Meltingth/WhizdomLift/docs/reference/HUD_VISUAL_REFERENCE.png

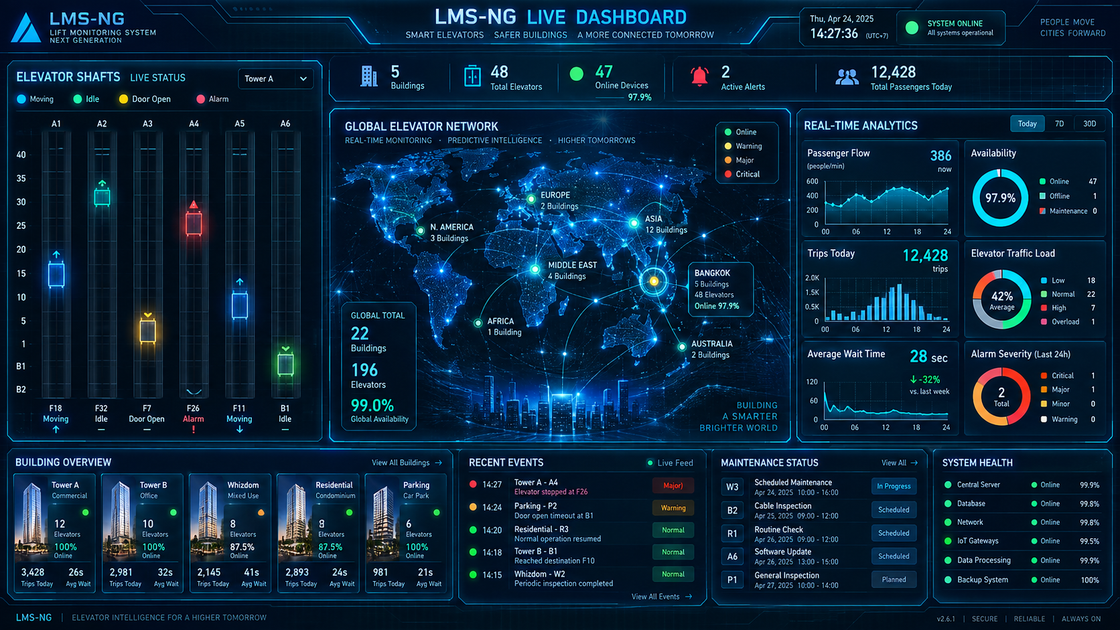
docs/reference/HUD_VISUAL_REFERENCE.png
