Meltingth/WhizdomLift/README.md

# WhizdomLift

ระบบอ่านสัญญาณตำแหน่งและสถานะลิฟต์ด้วย Arduino Mega 2560 — อ่านหน้าสัมผัสรีเลย์จากตู้ควบคุมลิฟต์ (รหัสตำแหน่ง 6 บิต VS2–VS7 + สถานะ RUNNING / SAFETY / UP / DN / FIRE) ผ่านแผงขั้วต่อ DNMEGA1 และโมดูลรีเลย์ 24V แบบ **read-only ทั้งระบบ** ไม่มีการขับสัญญาณกลับเข้าตู้ลิฟต์

🧭 **เริ่มอ่านที่นี่:** [CLAUDE.md](CLAUDE.md) — บริบทโปรเจกต์ฉบับเต็ม: แผนที่ขาที่ยืนยันแล้ว, สูตรถอดรหัส, กฎความปลอดภัย (**ห้ามตั้งขาเป็น OUTPUT**), บทเรียนจากบั๊กที่เคยให้คำตอบผิด และงานที่ยังเหลือ

🔧 **อัปเกรด firmware:** [FIRMWARE_UPGRADE.md](FIRMWARE_UPGRADE.md) — ทำที่เครื่องหน้าตู้ผ่าน USB เท่านั้น

🌐 **เครื่อง Gateway (รับ 5 ลิฟต์พร้อมกัน):** [GATEWAY.md](GATEWAY.md)

🔧 **แยกบอร์ดรีเลย์เสีย vs สาย input ขาด:** [LIFT1_VS2_RELAY_TEST.md](LIFT1_VS2_RELAY_TEST.md) — ขั้นตอนหน้าตู้สำหรับ Lift 1 VS2

🛗 **สถานะลิฟต์ทั้ง 5 ตัว + ขั้นตอนทดสอบ:** [LIFT_STATUS.md](LIFT_STATUS.md) — ลิฟต์ไหนตรวจแล้ว เจออะไร ต้องซ่อมอะไร

📋 **ผลการทดสอบล่าสุด:** [TEST_REPORT_2026-08-08.md](TEST_REPORT_2026-08-08.md) — ยืนยันความแม่นยำด้วย blind test 14/14 เหตุการณ์ พร้อมตารางสอบเทียบรหัส↔ชั้น และ checklist งานที่เหลือร่วมกับทีมดูแลลิฟต์

## โครงสร้าง

| ไฟล์ | หน้าที่ |
|---|---|
| `CLAUDE.md` | บริบทโปรเจกต์ + ข้อเท็จจริงที่ยืนยันแล้ว + บทเรียนจากบั๊ก — โหลดเข้า context อัตโนมัติทุก session |
| `TEST_REPORT_2026-08-08.md` | รายงานผลการทดสอบวันที่ 8 ส.ค. 2026 |
| `IODebug/IODebug.ino` | Sketch บนบอร์ด: อ่าน D2–D53 + A0–A15, watch mode ส่ง `ST <ms> <mask>` ทุกการเปลี่ยนแปลง |
| `LIFT_STATUS.md` | ตารางสถานะลิฟต์ทั้ง 5 + ขั้นตอนทดสอบทีละตัว |
| `GATEWAY.md` | คู่มือเครื่อง Gateway: รับ 5 ลิฟต์ผ่าน RS485 พร้อมกัน |
| `FIRMWARE_UPGRADE.md` | ขั้นตอนอัปเกรด firmware และสิ่งที่ Gateway จะเห็นระหว่างนั้น |
| `log_lift.py` | ตัวบันทึกถาวรต่อลิฟต์: `python log_lift.py COM3 3` — reconnect อัตโนมัติ, heartbeat 60 วิ, กันข้อมูลลิฟต์ปนกัน |
| `lift_health.py` | ตรวจสุขภาพลิฟต์เทียบลิฟต์ A: `python lift_health.py 2` — ชี้เส้นที่ไม่ส่งสัญญาณ |
| `rs485_check.py` | ตรวจลิงก์ RS485 แบบไม่ส่งอะไรออกสาย: `python rs485_check.py COM3 1` — บอกว่าบัสมีคนขับหรือไม่ |
| `lift_decode.py` | Config กลาง: แผนที่ขา→บิตของแต่ละลิฟต์ + ตารางแปลงรหัส→ป้ายชั้น |
| `analyze_lift.py` | ถอดแผนที่บิตอัตโนมัติจากพฤติกรรมสัญญาณ + ไทม์ไลน์ชั้น |
| `trips.py` | แยกเที่ยววิ่ง จุดจอด จุดแวะรับ + จำแนกสัญญาณสถานะ |
| `compare_lifts.py` | เทียบ wiring และรหัสระหว่างลิฟต์หลายตัว |
| `audit.py` / `reveal.py` / `probe_pin.py` | ตรวจข้อมูลดิบ, ตรวจคำตอบ blind test, ทดสอบขาแบบสด |
| `monitor.py` / `scan_pins.py` / `selftest.py` | เครื่องมือ serial monitor, สแกนหาขาที่ต่อจริง, ทดสอบบอร์ด |
| `capture_lift_N.log` | ข้อมูลดิบต่อลิฟต์ (N = เลขลิฟต์จริง 1–5) |

## เริ่มใช้งาน

```
# อัปโหลด sketch (ครั้งแรกต่อบอร์ด)
arduino-cli compile --fqbn arduino:avr:mega:cpu=atmega2560 IODebug
arduino-cli upload -p COM3 --fqbn arduino:avr:mega:cpu=atmega2560 IODebug

# เริ่มเก็บข้อมูล — ระบุชื่อลิฟต์เสมอ (หนึ่งโปรเซสต่อลิฟต์)
python log_lift.py COM3 3      # Lift 3
python log_lift.py COM5 2      # Lift 2

# หยุดทุกตัว: สร้างไฟล์ STOP_CAPTURE ในโฟลเดอร์นี้

# ตรวจสุขภาพ + วิเคราะห์
python lift_health.py 3
python trips.py
python compare_lifts.py
```

# LMS-NG Claude Code Workflow Kit v1.0 (2026-09-03)
วิธีติดตั้ง (ทำในทั้งสอง repo: `lms-ng` และ `WhizdomLift`)
1. คัดลอกโฟลเดอร์ `.claude/`, `scripts/`, `docs/workflow/`, `WORKFLOW_STATE.md` ไปไว้ที่ root ของ repo
2. เปิด `CLAUDE.workflow.md` แล้วต่อท้ายเนื้อหาเข้าไปใน `CLAUDE.md` ของ repo (WhizdomLift มี CLAUDE.md อยู่แล้ว ห้ามแทนที่ ให้ต่อท้าย)
3. อัปเดต Claude Code ก่อนเริ่มทุกเฟส: `claude update`  (alias `fable/opus/sonnet` จะชี้รุ่นล่าสุดเอง)
4. เริ่มเซสชัน: `claude`  (settings.json ตั้ง model=fable + ultracode=true ให้แล้ว) หรือบังคับ `claude --model fable --effort ultracode`
5. ตรวจ: `/status` ต้องขึ้น Fable + ultracode · `claude plugin validate .claude/agents` ต้องไม่มี error
6. รัน `/phase P0` แล้วไล่ทีละเฟสตาม docs/workflow/PHASES.md
หมายเหตุ: อย่าตั้ง env `CLAUDE_CODE_EFFORT_LEVEL` (จะทับ effort ของ subagent และปิด ultracode) · บน Windows hooks ต้องเป็น PowerShell · Fable อาจใช้ usage credits และมี consent prompt ครั้งแรก
