Meltingth/WhizdomLift/WORKFLOW_STATE.md

# Workflow state (maintained by the lead)
| Field | Value |
|---|---|
| Current phase | P0 |
| Base commit | - |
| Cycle | 0 |
| Last step completed | - |
| DoD progress | 0/0 |
| Blockers for human | - |
