Meltingth/WhizdomLift/FIRMWARE_UPGRADE.md

# ขั้นตอนอัปเกรด Firmware

**ทำที่เครื่อง debug หน้าตู้ ผ่าน USB เท่านั้น** — เครื่อง Gateway อัปเกรดไม่ได้
เพราะลิงก์ RS485 เป็นแบบส่งทางเดียว บอร์ดรับข้อมูลไม่ได้

---

## ข้อดีของการต่อแบบส่งทางเดียว: ไม่ต้องถอดอะไรเลย

เพราะ **`RO` ของ MAX485 ไม่ได้ต่อ** จึงไม่มีอะไรชนกับ CH340 ที่ขา D0
⇒ **เสียบ USB เข้าไปแฟลชได้ทันทีโดยไม่ต้องถอดสาย RS485 ออก**
และ Gateway ก็ไม่ต้องหยุดเก็บข้อมูล

## สิ่งที่ Gateway จะเห็นระหว่างอัปเกรด — และทำไมไม่ต้องตกใจ

| ช่วง | Gateway เห็นอะไร |
|---|---|
| ระหว่างอัปโหลด | **เงียบ** — บรรทัด `ST` หยุดไปเฉย ๆ ทราฟฟิก bootloader ถูกทิ้งโดยไม่นับ (ดูด้านล่าง) |
| บอร์ดพร้อม | `--- FW IODebug <version> <date> ---` ← **ยืนยันว่าเวอร์ชันใหม่ขึ้นแล้ว** |
| บอร์ดรีบูต | `--- board restarted (clock ... -> ...) ---` |

**ลำดับคือ FW มาก่อน restart** ไม่ใช่กลับกัน — `setup()` พิมพ์ banner แล้ว FW
แล้วจึงค่อย `emitState()` เป็นบรรทัดแรก ส่วนตัว marker "restarted" เขียนตอนเจอ `ST`
ที่เวลาบอร์ดถอยหลัง ซึ่งก็คือบรรทัดนั้นเอง เห็นจริงใน `capture_lift_2.log`:

```
--- FW IODebug 1.1.0 2026-08-30 18:57:20 ---
--- board restarted (clock 22891 -> 89) 18:57:20 ---
```

> บอร์ดที่ยังเป็นเวอร์ชันเก่าไม่มีบรรทัด FW จึงเห็นแต่ `board restarted` เดี่ยว ๆ
> (เช่นตอน 18:55:59 ที่เปิดพอร์ต USB แล้วบอร์ดรีเซ็ต) — **ไม่มี FW = เวอร์ชันก่อน 1.1.0 ไม่ใช่ลิงก์เสีย**

⚠️ ข้อจำกัดเล็กน้อย: การตรวจรีสตาร์ตใช้เงื่อนไข `ms < last_ms` เท่านั้น
ถ้าบอร์ดรีบูตแล้ว `ST` แรกบังเอิญได้เวลาเท่าเดิมพอดี จะไม่มี marker
(เกิดจริงตอน 18:57:24 — `ST 89` ซ้ำค่าเดิม) กรณีนี้ต้องอาศัยบรรทัด FW เป็นตัวจับแทน

### ⚠️ `rejected` **ไม่**พุ่งระหว่างอัปโหลด — ถ้าพุ่งแปลว่ามีปัญหาจริง

`log_lift.py` นับ `rejected` เฉพาะบรรทัดที่**ผ่าน** `startswith("ST ")` มาแล้วแต่รูปแบบผิด
ทราฟฟิก bootloader เป็นไบนารี แทบไม่มีทางขึ้นต้นด้วย `ST ` จึงตกที่
`if not line.startswith("ST "): continue` ถูกทิ้งเงียบ ๆ โดยไม่ถูกนับ

ทดสอบแล้วด้วยเฟรม STK500v2 จำลอง 110,000 ไบต์ (0x1B / seq / size / token 0x0E /
เพจ 256 ไบต์ + response): แตกได้ 827 ชิ้น — accepted 0, **rejected 0**, ทิ้งเงียบ 827
คำนวณตรง ๆ ก็ตรงกัน โอกาสที่ `0x53 0x54 0x20` จะตกหลัง `0x0A` พอดีอยู่ที่ราว 6×10⁻⁸ ต่อชิ้น

**ยืนยันจากการอัปเกรด Lift 2 จริง** (`capture_lift_2.log`): `ST` บรรทัดสุดท้ายก่อนแฟลช
อยู่ที่ 18:56:22.496 แล้ว **เงียบสนิท 58 วินาที** จนถึง 18:57:20 ไม่มีบรรทัดเสียแม้แต่บรรทัดเดียว
และรอบก่อนหน้าปิดด้วย `573 changes in 19.0 min, 0 rejected`

⇒ **`rejected` ต้องเป็น 0 ตลอด รวมทั้งระหว่างอัปเกรด**
ถ้าเห็นมันขยับในช่วงอัปเกรด นั่นคือ termination / คู่สาย A-B / baud มีปัญหาจริง
**ห้ามมองข้ามเพราะคิดว่าเป็นผลข้างเคียงของการแฟลช**

**แจ้ง Gateway ก่อนอัปเกรดทุกครั้ง** เพื่อให้รู้ว่าช่วงที่ `ST` เงียบหายไปนั้นเป็นเรื่องปกติ

## ขั้นตอน

### 1. เตรียม toolchain

```
export ARDUINO_DIRECTORIES_DATA=<scratchpad>/tools/data
export ARDUINO_DIRECTORIES_DOWNLOADS=<scratchpad>/tools/dl
export ARDUINO_DIRECTORIES_USER=<scratchpad>/tools/user
```

> scratchpad เป็นพื้นที่ชั่วคราว **ถูกล้างได้** ถ้า `avrdude.conf` หาย ให้ลบโฟลเดอร์
> `data/packages/arduino/tools/avrdude` แล้วสั่ง `arduino-cli core install arduino:avr` ใหม่
> (การสั่ง install เฉย ๆ จะข้าม เพราะเห็นว่าไฟล์ .exe ยังอยู่)

### 2. เพิ่มเลขเวอร์ชันก่อนแก้โค้ดเสมอ

ใน `IODebug/IODebug.ino`:
```c
#define FW_VERSION "1.1.0"
#define FW_DATE    "2026-08-30"
```
**บังคับ** — ถ้าไม่บวกเลข จะไม่มีทางรู้ว่าลิฟต์ตัวไหนได้อัปเดตแล้วบ้าง

### 3. ตรวจความปลอดภัยก่อน compile

```
grep -nE "OUTPUT|digitalWrite|Serial[123]" IODebug/IODebug.ino
```
**ต้องไม่เจออะไรเลย** ถ้าเจอแปลว่ามีโค้ดที่จะขับขาออก หรือเปิด UART ที่ทับสายสัญญาณ

### 4. Compile — **ต้องมีทั้ง `--export-binaries` และ `-DLIFT_ID`**

```
arduino-cli compile --fqbn arduino:avr:mega:cpu=atmega2560 --warnings all --export-binaries --build-property build.extra_flags=-DLIFT_ID=2 IODebug
```

🔴 **`-DLIFT_ID` ไม่ใช่ของเสริม** เลขลิฟต์ถูกฝังตอน compile ถ้าไม่ใส่ บอร์ดจะประกาศ
`LIFT=0` ซึ่งไม่ใช่เลขลิฟต์ที่มีจริง — เป็นค่า default ที่ตั้งใจให้ผิดแบบเห็นได้
(`log_lift.py` จะเตือนว่า *"firmware built without -DLIFT_ID"*) แต่ก็ยอมให้บันทึกต่อ
⇒ ได้ล็อกที่ **ไม่มีอะไรยืนยันว่ามาจากลิฟต์ตัวไหน** ซึ่งคือความล้มเหลวที่ระบบเลขนี้มีไว้กันพอดี

| ลิฟต์จริง | label เดิม | ใส่ `-DLIFT_ID=` |
|---|---|---|
| Lift 1 | B | `1` |
| Lift 2 | C | `2` |
| Lift 3 | A | `3` |
| Lift 4 | D | `4` |
| Lift 5 | E | `5` ⚠️ เลขนี้ยังไม่ยืนยัน ถามทีมดูแลลิฟต์ก่อน |

**hex ของแต่ละลิฟต์ใช้แทนกันไม่ได้** เพราะเลขอยู่ในไบนารี — เก็บแยกที่ `firmware/lift<n>/`
และตอน copy ต้องเช็คว่าหยิบถูกโฟลเดอร์ ไฟล์ทั้งสองขนาดเท่ากันเป๊ะ (27,390 ไบต์) จึงดูด้วยตาไม่ออก

⚠️ `arduino-cli compile` เฉย ๆ จะ build ลงโฟลเดอร์ชั่วคราว **`IODebug/build/` จะไม่ถูกแตะเลย**
แฟล็กนี้ถูกใส่ครั้งเดียวตอน `f45ca99` แล้วไม่ถูกใส่อีก ทำให้ hex ที่ track ไว้ค้างอยู่ที่
**build แรกสุดของโปรเจกต์ (7,396 ไบต์ เทียบกับปัจจุบัน 9,552)** — เก่ากว่าทั้งการ arm ตัวเอง
และเก่ากว่าการแก้บั๊ก §6.1 ⇒ ใครแฟลชบอร์ดสำรองจากไฟล์นั้นจะได้ firmware ที่
**พิมพ์ EDGE กับ snapshot ระหว่างเก็บข้อมูล** ซึ่งเคยทำให้อ่านบิตเร็วสุดตกและเลื่อนทุกบิตมาแล้ว

### 5. ตรวจว่า hex ที่ track ตรงกับ source

```
python check_firmware_hex.py
```

ต้องได้ `OK - the tracked hex matches the current source`
วินัยอย่างเดียวจับเรื่องนี้ไม่ได้มาหลายสัปดาห์แล้ว จึงต้องให้เครื่องตรวจแทน

### 6. Upload

```
arduino-cli upload -p COM3 --fqbn arduino:avr:mega:cpu=atmega2560 IODebug
```

### 7. ยืนยันว่าขึ้นเวอร์ชันใหม่จริง

```
python -c "
import serial, time
s = serial.Serial('COM3', 115200, timeout=0.2)
time.sleep(4); print(s.read(2000).decode('utf-8','replace'))
s.close()"
```
ต้องเห็น `FW IODebug <เวอร์ชันใหม่> <วันที่> LIFT=<เลขลิฟต์>` และมี `ST` ตามมาเองโดยไม่ต้องส่งคำสั่ง

**ตรวจเลขลิฟต์ตรงนี้ให้แน่** — ถ้าได้ `LIFT=0` แปลว่าลืม `-DLIFT_ID` ในขั้นที่ 4 ให้ย้อนกลับไป
compile ใหม่ ถ้าได้เลขอื่นที่ไม่ใช่ลิฟต์ที่กำลังแฟลช แปลว่าหยิบผิดโฟลเดอร์ `firmware/lift<n>/`
นี่เป็นจุดเดียวที่จับได้ก่อนบอร์ดจะกลับเข้าตู้ — หลังจากนั้นต้องเข้าห้องเครื่องซ้ำ

### 8. ตรวจว่ายังอ่านสัญญาณถูก

```
python lift_health.py <lift>
```
ต้องได้ `HEALTHY` และ single-step 100% เหมือนเดิม

### 9. commit + push แล้วแจ้ง Gateway

บอกว่าอัปเกรดลิฟต์ไหนเป็นเวอร์ชันอะไร Gateway จะเห็นบรรทัด `FW` ในล็อกตรงกัน
**ต้อง commit ไฟล์ hex ที่ build ใหม่ไปด้วย** ไม่งั้นจะกลับไปค้างแบบเดิม

---

## กฎที่ห้ามละเมิดตอนแก้ firmware

1. **ห้ามตั้งขาใดเป็น `OUTPUT`** — ขาต่อกับหน้าสัมผัสรีเลย์ ขับ HIGH ใส่หน้าสัมผัสที่ปิดอยู่ = พอร์ตพัง
2. **ห้ามพิมพ์อะไรเพิ่มใน watch mode** — บัฟเฟอร์เต็มจะบล็อกลูปสุ่มตัวอย่างและอ่านบิตที่เร็วที่สุดตกหล่น
   เคยทำให้ถอดรหัสผิดทั้งระบบมาแล้ว (`CLAUDE.md` §6.1)
3. **ห้ามเรียก `Serial1.begin()` / `Serial2.begin()`** — ทับ D16/D17/D19 ที่เป็น RUNNING, SAFETY, UP
4. **ห้ามขยับ `DIG_FIRST` / `DIG_LAST`** — ล็อกเก่าทุกไฟล์จะถอดไม่ได้

## ถ้าจำเป็นต้อง rollback

อิมเมจเดิมของแต่ละบอร์ดอยู่ใน `firmware_backup/` (ปัจจุบันมีของ Lift 2 ก่อนเขียนทับ)
**อ่าน flash เก็บไว้ก่อนเขียนทับเสมอ** ถ้าบอร์ดนั้นมีโปรแกรมของทีมอื่นอยู่:

```
avrdude -C <conf> -c wiring -p m2560 -P COM3 -b 115200 \
        -U flash:r:firmware_backup/lift<N>_original.hex:i
```
