Meltingth/WhizdomLift/LIFT2_STEP2A.md

# Lift 2 — ขั้นที่ 2A: วิธีวัดแบบละเอียด

## ก่อนอื่น: แยกสองฝั่งของโมดูลรีเลย์ให้ออก

โมดูลรีเลย์มีขั้วสองฝั่ง และ**คำว่า COM ปรากฏทั้งสองฝั่งแต่คนละความหมาย**
นี่คือจุดที่สับสนได้ง่ายที่สุด

```
            ฝั่งขาเข้า (24V)                      ฝั่งขาออก (หน้าสัมผัสแห้ง)
         ┌──────────────────┐                  ┌──────────────────────┐
         │  DC+   DC−       │   ┌────────┐     │  COM1  NO1  NC1      │
         │  IN1  IN2 ... IN8│───│ รีเลย์ │─────│  COM2  NO2  NC2      │
         └──────────────────┘   │ (กล่อง │     │   ...                │
              ▲                 │  ฟ้า)  │     └──────────────────────┘
              │                 └────────┘              │
       มาจากตู้ควบคุมลิฟต์                        ไปที่ DNMEGA1 / Arduino
       ขั้วเล็ก เรียงเป็นแถว                    ขั้วใหญ่กว่า จัดเป็นชุดละ 3
       มีเลข IN1..IN8 กำกับ                     ติดกับกล่องรีเลย์สีฟ้า
       ▶ DC− อยู่ที่ลบของ 24V เป็นเรื่องปกติ      ▶ COM ต้องไปหา GND ของ Arduino
```

**จุดสังเกตที่แยกได้แน่นอน:** ขั้วฝั่งขาออกจะ**อยู่ติดกับกล่องรีเลย์สีฟ้า** และจัดกลุ่ม
ละ 3 ขั้ว (COM / NO / NC) ต่อรีเลย์หนึ่งตัว ส่วนฝั่งขาเข้าเป็นขั้วเล็กเรียงยาวแถวเดียว
มีเลข IN กำกับ

> ที่คุณวัดได้ 24V เทียบกับขั้วบวกนั้น **น่าจะเป็นฝั่งขาเข้า (DC−)** ซึ่งอยู่ที่ลบของ
> แหล่งจ่าย 24V เป็นเรื่องถูกต้องอยู่แล้ว ไม่ใช่ตัวที่เรากำลังสงสัย

---

## ตั้งมัลติมิเตอร์

หมุนไปที่ **V⎓ / DCV** (โวลต์กระแสตรง) ช่วง 200V หรือ auto — **ไม่ใช่ ACV ไม่ใช่โอห์ม**
เปิดไฟระบบไว้ตามปกติ ลิฟต์จอดอยู่ก็ได้

**สายดำเสียบช่อง COM ของมิเตอร์ สายแดงเสียบช่อง V** (ตามปกติ)

---

## การวัด 3 ครั้ง — สายดำอยู่ที่เดิมตลอด

**สายดำ (−) คาไว้ที่ขั้ว `GND` บน DNMEGA1 ตลอดทั้งสามครั้ง อย่าขยับ**

นี่คือกราวด์อ้างอิงของ Arduino — ทุกอย่างวัดเทียบกับจุดนี้

| ครั้งที่ | เอาสายแดงไปแตะที่ | ควรได้ | ถ้าไม่ตรง |
|---|---|---|---|
| **A** | ขั้ว **ลบ (−)** ของแหล่งจ่าย 24VDC | **0 V** | 🎯 **เจอสาเหตุ** — กราวด์สองระบบไม่ได้เชื่อมกัน |
| **B** | **COM ฝั่งขาออก** ของโมดูล **8 ช่อง** (ตัวที่เสีย) | **0 V** | 🎯 **เจอสาเหตุ** — COM ไม่ได้อยู่ที่กราวด์ Arduino |
| **C** | **COM ฝั่งขาออก** ของโมดูล **6 ช่อง** (ตัวที่ดี) | **0 V** | ผิดคาด — บอกผมทันที |

### การอ่านผล

- **ได้ 0 V (หรือไม่กี่มิลลิโวลต์)** → จุดนั้นเชื่อมกับกราวด์ Arduino จริง ผ่าน
- **ได้ 24 V** → จุดนั้นอยู่บนราง 24V ไม่ใช่กราวด์ Arduino
- **ได้ค่าลอย ๆ ไม่นิ่ง เช่น 3V, 11V, แกว่งไปมา** → **ไม่ได้เชื่อมกันเลย** เป็นค่าที่
  มิเตอร์อ่านจากจุดลอย ← อาการนี้ก็คือเจอสาเหตุเหมือนกัน

### ทำไมต้องวัด C ด้วย

ครั้ง C คือ**ตัวเทียบ** โมดูล 6 ช่องทำงานได้สมบูรณ์อยู่แล้ว การวัดมันจึงบอกว่า
"ของที่ถูกต้องต้องอ่านได้เท่าไร" ด้วยมิเตอร์ตัวเดียวกัน ในตู้เดียวกัน นาทีเดียวกัน

**ถ้า C ได้ 0 V แต่ B ไม่ได้ → นั่นคือคำตอบ ไม่ต้องเดาอีก**

---

## ทางเลือก: วัดด้วยโอห์ม (แม่นกว่า แต่ต้องดับไฟ)

ถ้าปิดไฟระบบได้ วิธีนี้ให้คำตอบชัดกว่า เพราะไม่มีแรงดันรบกวน

1. **ดับไฟ 24V และถอด USB ของ Arduino ออก**
2. ตั้งมิเตอร์ที่ **Ω** หรือโหมดเช็คความต่อเนื่อง (มีเสียงบี๊บ)
3. วัดระหว่าง **ขั้ว GND บน DNMEGA1** กับ **COM ฝั่งขาออกของโมดูล 8 ช่อง**

| ผล | แปลว่า |
|---|---|
| **ใกล้ 0 Ω / บี๊บ** | เชื่อมกันอยู่ ไม่ใช่สาเหตุ → ไปวัดรายช่องต่อ |
| **ค่าเปิด / ไม่บี๊บ** | 🎯 **ไม่ได้เชื่อมกัน — นี่คือสาเหตุ** |

ทำซ้ำกับโมดูล 6 ช่องเพื่อเทียบ

---

## ⚠️ ห้ามทำ

- **อย่าเอาจัมเปอร์ต่อระหว่างสองจุดก่อนวัดโวลต์** ถ้าต่างศักย์กันจริง จะลัดวงจร 24V
  เข้าขา Arduino และพอร์ตพังทันที — **วัดให้ได้ 0 V ก่อนเท่านั้นจึงจะต่อได้**
- อย่าแตะสายแดงที่ขั้ว **DC+** หรือ **IN** ขณะสายดำคาอยู่ที่ GND ของ Arduino
  (วัดได้ แต่ถ้ามือลื่นไปโดนขาอื่นจะเสียหาย)

---

## ถ้าทั้ง A, B, C ได้ 0 V หมด

แปลว่ากราวด์ถูกต้องทั้งระบบ ปัญหาอยู่ที่**สายรายช่อง** ให้วัดต่อ:

ดับไฟแล้วตั้งโอห์ม วัดระหว่าง **ขั้ว 16 บน DNMEGA1** กับ **ขั้ว NO ของช่อง RUNNING**
บนโมดูล 8 ช่อง

- **ใกล้ 0 Ω** → สายดี ปัญหาอยู่ที่หน้าสัมผัสรีเลย์เอง (ช่องนั้นเสีย)
- **ค่าเปิด** → **สายเส้นนั้นไม่ได้ลงขั้วจริง** ซึ่งเข้ากับอาการ noise พอดี
  (สายมีอยู่ ปลายด้าน Arduino ต่อแน่น แต่ปลายด้านโมดูลลอย)

ทำซ้ำกับขั้ว 17, 19, 20 คู่กับช่อง SAFETY, UP, DN ตามลำดับ
