Meltingth/WhizdomLift/LIFT1_VS2_RELAY_TEST.md

# Lift 1 VS2 — บอร์ดรีเลย์เสีย หรือสาย input ขาด?

ขั้นตอนหน้าตู้ เรียงจาก**ความเสี่ยงต่ำสุดไปสูงสุด** ทำข้อ 1 ก่อนเสมอ เพราะมันตอบคำถามนี้ได้เลย
โดยไม่ต้องแตะอะไรสักชิ้น

---

## สิ่งที่ตัดออกไปได้แล้ว — อย่าเสียเวลาไล่ซ้ำ

| ส่วน | สถานะ | หลักฐาน |
|---|---|---|
| ขา D24 บน Arduino | ✅ ดี | จัมเปอร์ GND เข้าขั้ว 24 → `VS2 CLOSED` **757 ST samples · 750 รหัสคี่** ค้างได้ขณะลิฟต์วิ่งจริง |
| ขั้ว 24 บน DNMEGA1 → บอร์ด | ✅ ดี | เดียวกัน |
| COM ฝั่งขาออกของโมดูล | ✅ ดี | อีก 5 บิต (VS3–VS7) ใช้ COM ร่วมกันบนโมดูลเดียวกัน ทำงานครบ |
| ไฟเลี้ยงโมดูล | ✅ ดี | เหตุผลเดียวกัน |
| **สายจากโมดูล → ขั้ว 24** | ✅ **น่าจะดี** | D24 รับไฟ AC เหนี่ยวนำได้ — ขาที่ลอยจริงจะอ่าน HIGH นิ่ง (§6.5) การรับฮัมได้แปลว่ามีสายยาวต่ออยู่ ปลายอีกด้านเปิด |

⇒ **เหลือสองอย่าง: รีเลย์ไม่ดูด (ฝั่ง input) หรือ ดูดแล้วหน้าสัมผัสไม่ต่อ (ฝั่ง output)**

---

## ข้อ 1 — ดู LED ขณะลิฟต์วิ่ง ⭐ ไม่ต้องแตะอะไร ตอบได้เลย

VS2 เป็นบิตต่ำสุด **ต้องสลับทุกชั้น** ส่วน VS7 สลับครั้งเดียวต่อ 32 ชั้น
⇒ ช่องที่กะพริบถี่ที่สุดในหกช่องคือ VS2 หาเจอได้โดยไม่ต้องนับขั้ว

สั่งลิฟต์วิ่ง 1 → 44 แล้วจ้องช่อง VS2:

| เห็นอะไร | แปลว่า | ไปต่อที่ |
|---|---|---|
| **กะพริบถี่ปกติ** | สัญญาณจากตู้มาถึง opto ดูดคอยล์ได้ครบ ⇒ **ฝั่ง input ดีทั้งหมด** | **หน้าสัมผัสรีเลย์เสีย** → ข้อ 4 |
| **ไม่กะพริบเลย** | คอยล์ไม่เคยดูด ⇒ **ฝั่ง input มีปัญหา** | สาย/หน้าสัมผัสตู้ → ข้อ 2 |
| กะพริบแต่จังหวะมั่ว | หน้าสัมผัสตู้ MC-10 สึก | ข้อ 2 |

> LED อยู่**ฝั่ง input** มันบอกว่าคอยล์ดูดหรือไม่ **ไม่ได้บอกว่าหน้าสัมผัสฝั่งขาออกต่อจริง**
> นี่คือเหตุผลที่ "LED กะพริบปกติ" ยังแปลว่าเสียได้

---

## ข้อ 2 — วัดแรงดันขา input ขณะลิฟต์วิ่ง (ต้องมีมิเตอร์)

วัด **DC โวลต์** ระหว่าง **ขั้ว 2 (VS2)** กับ **ขั้ว 1 (คอมมอน input = MC-1)** บนโมดูล 6 ช่อง

ขณะรถวิ่ง ค่าต้องสลับไปมาระหว่าง ~24 V กับ ~0 V ตามจังหวะที่หน้าสัมผัส MC-10 เปิด/ปิด

| อ่านได้ | แปลว่า |
|---|---|
| สลับ 24V ↔ 0V ตามชั้น | สายจากตู้**ดี** → ปัญหาอยู่ในโมดูล (opto หรือคอยล์ หรือหน้าสัมผัส) |
| ค้างที่ 24V ไม่เปลี่ยน | **หน้าสัมผัส MC-10 ในตู้ไม่ทำงาน** หรือสายขาด |
| ค้างที่ 0V | สายลัดลงคอมมอน |
| ไม่มีแรงดันเลยทั้งสองขั้ว | ไฟเลี้ยงฝั่ง input ของโมดูลไม่มา — แต่ช่องอื่นทำงาน จึงไม่น่าใช่ |

> 🔴 **ห้ามวัดเทียบกับ GND ของ Arduino เด็ดขาด** ฝั่ง 24V กับฝั่ง 5V ถูกแยกกันด้วยโมดูลโดยตั้งใจ
> (CLAUDE.md §2) การเอากราวด์สองฝั่งมาเจอกันคือการทำลายฉนวนชั้นเดียวที่ระบบนี้มี

---

## ข้อ 3 — สลับสาย input กับช่องที่ดี ⭐ ตัดสินขาด ไม่ต้องใช้มิเตอร์

ทดสอบที่ตอบคำถาม "บอร์ดเสีย หรือ สายขาด" ได้ตรงที่สุด โดยใช้ช่องที่ดีเป็นตัวควบคุม

**สลับเฉพาะสาย input ของ VS2 กับ VS3** (ขั้ว 2 ↔ ขั้ว 3) — **อย่าแตะสายฝั่งขาออก** แล้วสั่งรถวิ่ง

| ผลที่ได้ | สรุป |
|---|---|
| **D25 เริ่มสลับถี่สุด, D24 ยังเงียบ** | สัญญาณ VS2 อยู่บนสายจริง → **ช่องรีเลย์ VS2 เสีย** |
| **D24 เริ่มสลับที่จังหวะช้าแบบ VS3, D25 เงียบ** | สาย VS2 ไม่มีสัญญาณ → **สาย input / หน้าสัมผัสตู้ขาด** |
| เงียบทั้งคู่ | ผิดคาด หยุดแล้วตรวจว่าสลับถูกขั้วไหม |

เพราะสายฝั่งขาออกไม่ถูกแตะ **ขา Arduino จึงบอกได้ว่าช่องไหนทำงาน** — อ่านผลอัตโนมัติด้วย

```
python pin_watch.py 1 D24        # และดู D25 คู่กัน
```

**อย่าลืมสลับกลับ**หลังทดสอบเสร็จ ไม่งั้นการถอดรหัสชั้นจะสลับบิตกัน

---

## ข้อ 4 — ตรวจหน้าสัมผัสฝั่งขาออกโดยตรง

ถ้าข้อ 1 บอกว่า LED กะพริบปกติ ให้พิสูจน์ว่าหน้าสัมผัสไม่ต่อจริง

**ขณะ LED ช่อง VS2 ติด** (จังหวะรถอยู่ชั้นที่ VS2 ควรปิด) วัด **ความต้านทาน** หรือ **DC โวลต์**
ระหว่าง **ขั้ว NO** กับ **ขั้ว COM ฝั่งขาออก** ของช่องนั้น

| อ่านได้ | แปลว่า |
|---|---|
| ใกล้ 0 Ω / ใกล้ 0 V | หน้าสัมผัสต่อจริง → ปัญหาอยู่ที่สายไปขั้ว 24 (แต่ข้อมูลฮัมบอกว่าสายน่าจะดี — ตรวจซ้ำ) |
| ค้างสูง / เปิดตลอด | **หน้าสัมผัสรีเลย์เสีย ยืนยันแล้ว** |

---

## ทำไมช่อง VS2 ถึงน่าจะเป็นช่องที่พังก่อนเพื่อน

VS2 เป็นบิตต่ำสุด ต้องสลับ**ทุกชั้น** ขณะที่ VS7 สลับครั้งเดียวต่อ 32 ชั้น
⇒ **หน้าสัมผัสช่องนี้ทำงานหนักกว่าเพื่อนราว 32 เท่า** และหน้าสัมผัสสึกตามจำนวนครั้งที่สลับ
ช่องที่พังก่อนจึงเป็นช่องที่ทำงานหนักที่สุดพอดี ซึ่งตรงกับอาการที่เจอ

---

## ถ้าสรุปว่าช่องรีเลย์เสีย — แก้ได้โดยไม่ต้องรอโมดูลใหม่

**โมดูลสถานะ 8 ช่องใช้อยู่แค่ 4 ช่อง** (RUNNING / SAFETY / UP / DN) ยังเหลือช่องว่าง
ย้าย VS2 ไปใช้ช่องว่างนั้นแล้วเดินสายขาออกเข้าขั้ว 24 ตามเดิมได้เลย

⚠️ แต่**โมดูล 8 ช่องใช้คอมมอน input คนละเส้น** (ขั้ว 13 และ 19) — ต้องต่อสาย MC-10 ให้ถูกคอมมอนของโมดูลนั้น
ไม่ใช่คอมมอนของโมดูล 6 ช่อง

---

## บันทึกผลกลับเข้า repo

หลังทดสอบเสร็จ ให้เติมผลลงตาราง Lift 1 ใน `LIFT_STATUS.md` แล้ว commit —
ข้อมูลการทดสอบเกิดจากการจองลิฟต์กับทีมดูแล ทำซ้ำไม่ได้ง่าย ๆ (CLAUDE.md §10)
