Meltingth/WhizdomLift/TEST_REPORT_2026-08-08.md

# รายงานผลการทดสอบระบบอ่านสัญญาณลิฟต์ — WhizdomLift

**วันที่ทดสอบ:** 8 สิงหาคม 2026 (14:20 – 16:40 น.)
**สถานที่:** ตู้ทดสอบ / อาคาร 44 ชั้น (มีชั้นใต้ดิน), ลิฟต์ทั้งหมด 5 ตัว — ทดสอบแล้ว 2 ตัว (A, B)
**สถานะ:** ✅ ระบบอ่านสัญญาณใช้งานได้จริง ยืนยันด้วย blind test 14/14 เหตุการณ์

> **หมายเหตุชื่อลิฟต์:** รายงานนี้เขียนตอนที่ยังเรียกลิฟต์ตามลำดับที่ต่อบอร์ด
> ชื่อจริงในอาคารคือ **ลิฟต์ A = Lift 3** และ **ลิฟต์ B = Lift 1**
> (ที่จะทดสอบต่อ: C = Lift 2, D = Lift 4) — ดูตารางล่าสุดที่ `LIFT_STATUS.md`

---

## 1. สรุปสำหรับผู้บริหาร

ระบบ Arduino Mega 2560 + แผงขั้วต่อ DNMEGA1 + โมดูลรีเลย์ 24V สามารถอ่านสัญญาณตำแหน่งและสถานะจากตู้ควบคุมลิฟต์ได้**ครบถ้วนและแม่นยำ** — ทดสอบแบบปิดตา (ผู้ทดสอบจดเวลา/ชั้นไว้ ระบบถอดรหัสจากสัญญาณล้วน ๆ) ตรงกันทั้ง 14 เหตุการณ์ รวมถึงการจอดแวะสั้นเพียง 8 วินาที

**พบความผิดปกติ 1 จุดที่ต้องแจ้งทีมดูแลลิฟต์:** สายสัญญาณบิตต่ำสุด (VS2) ของลิฟต์ B ไม่ถึงบอร์ด ทำให้อ่านตำแหน่งลิฟต์ B ได้หยาบเป็น 2 เท่าของช่วงชั้น (ดูหัวข้อ 6)

---

## 2. สถาปัตยกรรมสัญญาณที่ยืนยันแล้ว

```
ตู้ควบคุมลิฟต์ (หน้าสัมผัส MC-1, MC-5..MC-10, คอมมอน 24V)
        │  สัญญาณตำแหน่ง 6 บิต (VS2..VS7) + สถานะ 6 เส้น
        ▼
โมดูลรีเลย์ 24VDC (6 ช่อง + 8 ช่อง, JQC-3FF-S-Z, จัมเปอร์ Com–High)
        │  หน้าสัมผัสแห้ง (dry contact) แยกกราวด์
        ▼
DNMEGA1 (แผงขั้วสกรู — ตัวนำสัญญาณล้วน ไม่มีวงจรแปลง)
        ▼
Arduino Mega 2560 — ทุกขาเป็น INPUT_PULLUP (ไม่ขับสัญญาณออกเลย)
        ▼  USB @115200, โปรโตคอล "ST <ms> <52-bit hex mask>"
PC — ตัวบันทึก log_lift.py (หนึ่งโปรเซสต่อลิฟต์)
```

- หน้าสัมผัสปิด = ขาอ่านได้ LOW = สัญญาณ active
- ทิศทางข้อมูล: **ตู้ลิฟต์ → Arduino เท่านั้น** sketch ไม่มีการขับขาใดเป็น OUTPUT ปลอดภัยต่อระบบลิฟต์ 100%

## 3. แผนที่ขาสัญญาณ (ยืนยันแล้ว)

### ลิฟต์ A = **Lift 3** (ตัวอ้างอิง)

| ขา Arduino | สัญญาณ | ความหมาย |
|---|---|---|
| D24 | VS2 | บิต 0 (น้ำหนัก 1) |
| D25 | VS3 | บิต 1 (น้ำหนัก 2) |
| D26 | VS4 | บิต 2 (น้ำหนัก 4) |
| D27 | VS5 | บิต 3 (น้ำหนัก 8) |
| D28 | VS6 | บิต 4 (น้ำหนัก 16) |
| D29 | VS7 | บิต 5 (น้ำหนัก 32) |
| D16 | RUNNING (运行) | ปิดขณะวิ่ง เปิดขณะจอด |
| D17 | SAFETY (安全) | ปิดเกือบตลอด (ทั้งจอดและวิ่ง) มีเปิดสั้น ๆ ที่ยังไม่ทราบจังหวะ |
| D19 | UP (上行) | ปิดเฉพาะวิ่งขึ้น (ขึ้น 100% / ลง 0%) |
| D20 | DN (下行) | ปิดเฉพาะวิ่งลง (ขึ้น 0% / ลง 100%) |

รหัสตำแหน่ง = ไบนารีตรง 6 บิต: `รหัส = 32·VS7 + 16·VS6 + 8·VS5 + 4·VS4 + 2·VS3 + VS2`
คุณภาพ: single-step **100%** จาก 2,008 สถานะเสถียร (ทุกการเปลี่ยนขยับทีละ 1 พอดี)

### ลิฟต์ B = **Lift 1**

สาย VS3..VS7 ลงขา D25..D29 **ตรงกับลิฟต์ A ทุกเส้น** แต่ **VS2 → D24 ไม่มีสัญญาณเลย** (LOW 0 ครั้งจาก 591 สถานะ) — ดูหัวข้อ 6

## 4. ตารางสอบเทียบ รหัส ↔ ป้ายชั้น (จากการจับเวลาจริง)

| ป้ายชั้น | รหัสที่อ่านได้ | offset |
|---|---|---|
| B1 | 1 | — |
| 1 | 2 | +1 |
| 9 | 12 | +3 |
| 20 | 22 | +2 |
| 26 | 28 | +2 |
| 32 | 34 | +2 |
| 33 | 35 | +2 |
| 36 | 38 | +2 |
| 37 | 39 | +2 |
| 44 (สูงสุด) | 46 | +2 |

**ข้อสังเกตเชิงโครงสร้าง**
- ตั้งแต่ชั้น 20 ขึ้นไป: `รหัส = ชั้น + 2` คงที่ตลอด ไม่มีชั้นข้ามเหนือชั้น 20
- offset หดจาก +3 → +2 ระหว่างชั้น 9 กับ 20 ⇒ **ชั้น 19 ไม่มีชานจอดจริง** (สอดคล้องกับที่ผู้ทดสอบเห็นลิฟต์ข้ามชั้น 19)
- offset โตจาก +1 → +3 ระหว่างชั้น 1 กับ 9 ⇒ มีชานจอดพิเศษ 2–3 ระดับระหว่างชั้น 1–9 (เกี่ยวพันกับชั้น 7 ที่ถูกข้าม) — **ยังปิดไม่ได้ ต้องจอดชั้น 2–8 เพิ่ม**
- ผู้ทดสอบรายงานว่าอาคารข้ามชั้น 7 และ 19

## 5. ผล Blind Test — 14/14 เหตุการณ์

ผู้ทดสอบจดเวลา/ชั้นเอง ระบบถอดรหัสจากสัญญาณโดยไม่รู้เฉลย แล้วนำมาเทียบ:

| เวลา | ลิฟต์ | เฉลย | ระบบถอดได้ | ผล |
|---|---|---|---|---|
| 15:51 | B | ถึงชั้น 44 | ไต่ถึงรหัสสูงสุด 23 (=46>>1 เพราะ VS2 ขาด) | ✓ |
| 15:53 | A | ถึงชั้น 44 | รหัส 46 | ✓ |
| 15:55–56 | A | 44 รอบ 2 แล้วลงถึง 1 | 46 → 2 | ✓ |
| 16:03 | A+B | จอดชั้น 1 ทั้งคู่ | A=2, B=1(=2>>1) | ✓ |
| 16:15:00 | A | เรียก 1→9 | จอดรหัส 12 (11.2 วิ) | ✓ |
| 16:15:28 | A | ต่อไป 20 | จอดรหัส 22 (8.6 วิ) | ✓ |
| 16:16:00 | A | ขึ้น 33 | จอดรหัส 35 (87 วิ) | ✓ |
| 16:17:35 | A | เรียกไป 32 | จอดรหัส 34 | ✓ |
| 16:18:27 | A | ลงมา 1 | จอดรหัส 2 | ✓ |
| 16:19:23 | A | ขึ้นไปรอ 33 | จอดรหัส 35 (179 วิ) | ✓ |
| 16:21 | B | ถึงชั้น 44 | ไต่ถึง 23 อีกครั้ง | ✓ |
| 16:23:48 | A | เรียกไป **B1** | จอด**รหัส 1** (8.7 วิ) | ✓ |
| 16:24–16:31 | A | จอดค้างชั้น 37 | จอดรหัส 39 นาน ~7 นาที | ✓ |
| 16:31–16:34 | A | 36 → 1 → 26 → 1 | 38 → 2 → 28 → 2 | ✓ |

## 6. 🔴 ข้อบกพร่องที่พบ — แจ้งทีมดูแลลิฟต์

### 6.1 ลิฟต์ B (**Lift 1**): สายสัญญาณ VS2 (บิตต่ำสุด) ไม่ถึงบอร์ด

- **อาการ:** ขา D24 ของลิฟต์ B ไม่เคยอ่านได้ LOW เลย (0 จาก 591 สถานะ) ขณะที่ลิฟต์ A ขานี้สลับถี่ที่สุด
- **ผลกระทบ:** ตำแหน่งลิฟต์ B อ่านได้หยาบ 2 ชั้นต่อ 1 รหัส (ค่า = รหัสจริง ÷ 2)
- **หลักฐาน:** ที่ชั้น 44 ลิฟต์ B อ่านได้ 23 = 46>>1 พอดี และสมมุติฐานนี้ให้ single-step 100% ขณะที่สมมุติฐานอื่นได้ 0–96%
- **วิธีชี้จุดขาด (ใช้ตาเปล่า):** ขณะลิฟต์ B วิ่ง ดู LED ช่อง VS2 บนโมดูลรีเลย์ของ B — ช่องนี้ต้องกะพริบถี่ที่สุด
  - LED กะพริบ แต่ D24 เงียบ → สายจากเอาต์พุตรีเลย์ → ขั้ว 24 ของ DNMEGA1 หลวม/ขาด
  - LED ไม่กะพริบ → สายจากตู้ควบคุม (MC-10/ALR0) → ขั้ว IN ของโมดูลขาด

### 6.2 บอร์ด Arduino ตัวแรกเสีย (เปลี่ยนแล้ว)

บอร์ดตัวแรก (CH340 clone) enumerate ผ่าน USB ได้แต่ MCU ไม่ตอบสนองใด ๆ (ทดสอบ bootloader หลายโปรโตคอล/baud, loopback — เงียบทุกทาง) เปลี่ยนบอร์ดใหม่แล้วใช้งานได้ทันที ควรคัดบอร์ดตัวเก่าออกหรือส่งซ่อม

### 6.3 บทเรียนทางเทคนิค (แก้ไขแล้ว)

Sketch เวอร์ชันแรกพิมพ์ข้อความ debug ระหว่างเก็บสัญญาณ ทำให้ serial buffer บล็อกลูปสุ่มตัวอย่างและอ่านบิตที่เร็วที่สุด (VS2) ตกหล่น จนตีความผิดเป็นสัญญาณพัลส์ — แก้โดยปิดการพิมพ์ทั้งหมดใน watch mode คุณภาพขึ้นจากอ่านได้ 5 บิตเพี้ยน เป็น 6 บิตสมบูรณ์ 100%

## 7. ข้อมูลที่เก็บได้

| ไฟล์ | เนื้อหา |
|---|---|
| `capture_lift_3.log` (213 KB) | Lift 3 (A) — 2,760 การเปลี่ยนสถานะ, 113.6 นาที |
| `capture_lift_1.log` (60 KB) | Lift 1 (B) — 990 การเปลี่ยนสถานะ, 89.3 นาที |
| `capture_lift_3_part1.log` (39 KB) | สำเนาข้อมูลช่วงแรก (ก่อนแก้ sketch) |

รูปแบบบรรทัด: `HH:MM:SS.mmm  <บอร์ด_ms>  <mask 52 บิต hex>  <ขาที่ปิด>`

## 8. เครื่องมือที่พัฒนา (พร้อมใช้รอบหน้า)

| ไฟล์ | หน้าที่ |
|---|---|
| `IODebug/IODebug.ino` | Sketch บนบอร์ด — อ่านทุกขา, watch mode (`w`), heartbeat (`e`), read-only 100% |
| `log_lift.py` | ตัวบันทึกถาวร: `python log_lift.py COM3 3` — ต่อพอร์ตใหม่อัตโนมัติ, heartbeat 60 วิ, หยุดด้วยไฟล์ `STOP_CAPTURE` |
| `lift_health.py` | ตรวจสุขภาพลิฟต์เทียบลิฟต์ A: `python lift_health.py 2` |
| `analyze_lift.py` | ถอดแผนที่บิตอัตโนมัติจากพฤติกรรม + ไทม์ไลน์ชั้น |
| `trips.py` | แยกเที่ยววิ่ง จุดจอด จุดแวะรับ + จำแนกสัญญาณสถานะ |
| `compare_lifts.py` | เทียบ wiring และรหัสระหว่างสองลิฟต์ |
| `reveal.py` | ตรวจคำตอบ blind test กับเฉลยผู้ทดสอบ |
| `audit.py` | ตรวจข้อมูลดิบหาบิตหาย/ขาเงียบ |
| `probe_pin.py` | ทดสอบขาแบบสด (แตะ GND ที่ขั้ว → ประกาศชื่อขา) |
| `lift_decode.py` | ไฟล์ config กลาง: แผนที่บิตทั้งสองลิฟต์ + ตารางแปลงรหัส→ชั้น |

**เริ่มเก็บข้อมูลรอบหน้า** — ระบุชื่อลิฟต์เสมอ ไม่ใช่แค่พอร์ต:
```
python log_lift.py COM3 3      # Lift 3
python log_lift.py COM5 1      # Lift 1
```
ขั้นตอนเต็มสำหรับทดสอบลิฟต์ที่เหลือ: ดู `LIFT_STATUS.md`

## 9. รายการทดสอบที่เหลือ — ทำร่วมกับทีมดูแลลิฟต์

| # | รายการ | วิธี | ผลที่คาด |
|---|---|---|---|
| 1 | **FIRE (火灾)** | กระตุ้นโหมดเพลิงไหม้ (คีย์สวิตช์/จุดทดสอบของทีมลิฟต์) | ขาใหม่จะอ่าน LOW — ระบุขาได้ทันทีด้วย `probe_pin.py` |
| 2 | **FIRE RETURN** | กระตุ้นโหมดกลับชั้นอพยพ | เช่นเดียวกัน |
| 3 | **ซ่อม VS2 ลิฟต์ B** | ตรวจตามหัวข้อ 6.1 แล้ววิ่งทดสอบ 1 เที่ยว | D24 ต้องเริ่มสลับ และรหัสสูงสุดต้องเป็น 46 |
| 4 | **ปิดตารางชั้นล่าง** | จอดลิฟต์ A ที่ชั้น 2,3,4,5,6,8 ชั้นละ ~10 วิ พร้อมจดเวลา | ได้ offset ครบ ระบุชานจอดแฝงระหว่างชั้น 1–9 |
| 5 | **ยืนยันชั้น 7** | สังเกตรหัสขณะวิ่งผ่านช่วง 6→8 | รู้ว่าชั้น 7 มีชานจอดจริง (มีรหัสคั่น) หรือไม่มี |
| 6 | **จังหวะเปิดของ SAFETY (D17)** | เปิดประตูค้าง / กดหยุดฉุกเฉิน พร้อมจดเวลา | ทราบความหมายการเปิดสั้น ๆ 8 ครั้งที่พบ |
| 7 | ลิฟต์ตัวที่ 3–5 | ต่อบอร์ดเพิ่ม (สคริปต์รองรับหลายพอร์ตแล้ว) | ครอบคลุมทั้งอาคาร |

---
*รายงานสร้างจากข้อมูลจริงทั้งหมดในล็อก — ทุกตัวเลขตรวจสอบย้อนกลับได้จากไฟล์ในหัวข้อ 7*
