Meltingth/WhizdomLift/LIFT2_TROUBLESHOOTING.md

# Lift 2 — ขั้นตอนตรวจหาสาเหตุสัญญาณสถานะไม่มา

**อาการ:** บิตตำแหน่ง (VS2–VS7) ทำงานสมบูรณ์ 100% แต่ **RUNNING / SAFETY / UP / DN
ไม่มีสัญญาณจริงเลย** — ทดสอบวิ่งเต็มรอบ ชั้น 1 ↔ 44 สองครั้ง ผลเหมือนกันทั้งสองรอบ

---

## หลักฐานที่มี

| ขา | สัญญาณ | Lift 2 | Lift 3 (ปกติ) |
|---|---|---|---|
| D24–D29 | VS2–VS7 ตำแหน่ง | ✅ median 954 ms – 100 วินาที | ✅ 974 ms – 74 วินาที |
| D16 | RUNNING | 🔴 17,252 ครั้ง แต่ p99 = **3 ms** | ✅ median **24 วินาที** |
| D17 | SAFETY | 🔴 96,372 ครั้ง p99 = **4 ms** | ✅ median **918 วินาที** |
| D19 | UP | 🔴 12,463 ครั้ง p99 = **3 ms** | ✅ median **20 วินาที** |
| D20 | DN | 🔴 11,296 ครั้ง p99 = **3 ms** | ✅ median **39 วินาที** |

**สแกนครบทั้ง 52 ขาแล้ว ไม่มีขาไหนรับสัญญาณสถานะได้เลย** จึงไม่ใช่การต่อผิดขา

## อ่านหลักฐานอย่างไร

พัลส์กว้าง 2–4 ms ที่ความถี่ 50–62 Hz **ไม่ใช่สัญญาณจากรีเลย์** เพราะหน้าสัมผัสเชิงกล
ใช้เวลาปิดตัวเอง 5–10 ms ยังไม่ทันปิดสนิทด้วยซ้ำ ความถี่ที่วัดได้ตรงกับไฟบ้าน 50 Hz
(ช่วงห่างที่พบบ่อยสุดคือ 20 ms = คาบเต็ม และ 10 ms = ครึ่งคาบ)

สิ่งที่บอกได้แม่นกว่านั้นคือ **ทำไมถึงเป็น noise แทนที่จะเป็น HIGH นิ่ง ๆ**

- ขา `INPUT_PULLUP` ที่**ไม่ได้ต่ออะไรเลย** → HIGH นิ่งสนิท (pullup 30 kΩ ชนะทันที)
- ขาที่ต่อกับ**สายยาวปลายลอย** → สายเป็นเสาอากาศ ไฟ AC เหนี่ยวนำเข้ามาราว 80 µA
  กดขาลงต่ำกว่า 2.5 V เป็นจังหวะ ๆ ← **นี่คือสิ่งที่วัดได้**

⇒ **สายจาก Arduino ไปโมดูลรีเลย์มีอยู่จริง แต่ปลายทางไม่เคยถูกต่อลงกราวด์**

## เบาะแสสำคัญที่สุด

ตามไดอะแกรมตู้ควบคุม สัญญาณแยกเป็นสองกลุ่มที่ใช้ **โมดูลรีเลย์คนละตัวและคอมมอนคนละเส้น**:

| กลุ่ม | ขั้ว | โมดูล | สถานะ Lift 2 |
|---|---|---|---|
| ตำแหน่ง VS2–VS7 | 1–7 (คอมมอนที่ 1) | 6 ช่อง | ✅ **ปกติทั้งหมด** |
| สถานะ RUNNING/SAFETY/FIRE/UP/DN | 13–20 (คอมมอนที่ 13 และ 19) | 8 ช่อง | 🔴 **เสียทั้งหมด** |

**ความเสียหายจำกัดอยู่ที่โมดูลเดียวแบบเบ็ดเสร็จ** — ทั้ง 4 เส้นตายพร้อมกันหมด
ไม่ใช่สายขาดทีละเส้น ให้มองหาสิ่งที่**ใช้ร่วมกันทั้งโมดูล** ไม่ใช่ไล่ทีละช่อง

---

## ขั้นตอนตรวจ

### ขั้นที่ 0 — ยืนยันว่าฝั่ง Arduino ปกติ (ทำได้ทันที ปลอดภัย)

```
python probe_pin.py
```

เอาสายจัมเปอร์แตะจาก **GND** ไปที่ขั้ว **D16** บน DNMEGA1

- **โปรแกรมประกาศ `NEW PIN: D16`** → ขา Arduino, ขั้วสกรู และลายวงจรระหว่างนั้นดีหมด
  **ปัญหาอยู่เหนือขึ้นไป** → ไปขั้นที่ 1
- **ไม่มีอะไรขึ้น** → ขาหรือขั้วนั้นเสีย (พบได้ยาก เพราะ noise บอกอยู่แล้วว่าสายต่อถึง)

ทำซ้ำกับ D17, D19, D20 ปลอดภัย 100% เพราะเป็นขา input ที่มี pullup กระแสแค่ 0.15 mA

### ขั้นที่ 1 — ดู LED ของโมดูลรีเลย์ 8 ช่อง ขณะลิฟต์วิ่ง ← **จุดชี้ขาด**

สั่งลิฟต์วิ่งขึ้นลง แล้วจ้องที่ LED ของโมดูลชุดสถานะ ช่อง RUNNING / UP / DN
ต้องติดตามจังหวะที่ลิฟต์เคลื่อนที่

| ที่เห็น | แปลว่า | ไปต่อที่ |
|---|---|---|
| **LED ติดตามจังหวะ** | สัญญาณ 24V จากตู้มาถึงโมดูลแล้ว ปัญหาอยู่**ฝั่งขาออก** | ขั้นที่ 2A |
| **LED ไม่ติดเลย** | สัญญาณไม่มาถึงโมดูล หรือโมดูลไม่มีไฟเลี้ยง | ขั้นที่ 2B |

### ขั้นที่ 2A — LED ติด แต่ Arduino ไม่เห็น (ปัญหาฝั่งขาออก)

**ตรวจสายคอมมอนขาออกก่อนเป็นอันดับแรก** — นี่คือสาเหตุที่อธิบายอาการได้ครบที่สุด

หน้าสัมผัสแห้งของโมดูลต้องต่อขา Arduino ลง **GND ของ Arduino** ถ้าสายคอมมอนฝั่ง
เอาต์พุตที่กลับมาเข้าขั้ว GND ของ DNMEGA1 หลุด หลวม หรือไม่เคยต่อ **ทั้ง 8 ช่อง
จะลอยพร้อมกันหมด** ตรงกับที่เจอเป๊ะ

1. หาสายคอมมอนจากฝั่งเอาต์พุต (COM) ของโมดูล 8 ช่อง → ขั้ว GND บน DNMEGA1
2. วัดความต่อเนื่องด้วยมัลติมิเตอร์: **ต้องได้ใกล้ 0 Ω** ระหว่าง COM ของโมดูลกับ GND ของ Arduino
3. **เทียบกับโมดูล 6 ช่องของ Lift 2 ที่ทำงานปกติ** — สายเส้นนี้ต้องมีเหมือนกัน
4. ถ้าดี ให้วัดต่อเนื่องทีละช่อง: COM ↔ ขั้ว D16/D17/D19/D20 **ขณะรีเลย์ช่องนั้นดูด**

### ขั้นที่ 2B — LED ไม่ติด (ปัญหาฝั่งขาเข้าหรือไฟเลี้ยง)

1. **LED เพาเวอร์ของโมดูลติดไหม** ถ้าไม่ติด → วัด 24V ที่ขั้ว DC+/DC− ของโมดูล
2. ถ้าไฟเลี้ยงมา → ตรวจ **คอมมอนฝั่งขาเข้า (ขั้ว 13 = หน้าสัมผัส MC-1)**
   จากตู้ควบคุม เส้นนี้เส้นเดียวหลุด สัญญาณทั้ง 6 เส้นในกลุ่มจะตายหมด
3. วัดแรงดันที่ขั้ว IN ของช่อง RUNNING เทียบกับคอมมอน **ขณะลิฟต์วิ่ง** ต้องได้ ~24V
4. ถ้าไม่มีแรงดัน → ปัญหาอยู่ในตู้ควบคุม (หน้าสัมผัส MC-10/ALR0 หรือสายก่อนถึงโมดูล)
   ต้องให้ทีมดูแลลิฟต์ตรวจ

### ขั้นที่ 3 — เทียบของจริงกับ Lift 3

Lift 3 ใช้งานได้สมบูรณ์และต่อแบบเดียวกัน **เปิดตู้ทั้งสองตัวเทียบกันตรง ๆ**
เป็นวิธีที่เร็วที่สุดในการหาเส้นที่ขาดหายไป โดยเฉพาะสายคอมมอนที่มักถูกมองข้าม

---

## ยืนยันหลังซ่อม

เก็บข้อมูลใหม่แล้ววิ่งลิฟต์ขึ้นลงหนึ่งรอบ:

```
python log_lift.py COM3 2
python lift_health.py 2
```

**ต้องได้:**

- ทั้ง 10 เส้นขึ้น `ok` ไม่มี `NOISE`
- D16/D19/D20 ต้องมี p99 ระดับ**หลายวินาที** ไม่ใช่หลักมิลลิวินาที
- D17 (SAFETY) ต้องปิดค้างเกือบตลอดเวลา
- verdict ขึ้น `HEALTHY`

ถ้ายังขึ้น `NOISE` แปลว่ายังไม่ถูกจุด — ค่า p99 จะบอกว่าดีขึ้นบ้างหรือไม่เปลี่ยนเลย
