Meltingth/WhizdomLift/(commit log)

2026-08-29 Lift signal reader: Arduino Mega 2560 + capture/analysis toolkit
    Read-only monitor for lift controller signals via 24V relay modules and
    a DNMEGA1 screw-terminal carrier: 6-bit position code (VS2-VS7) plus
    RUNNING / SAFETY / UP / DN status lines.
    Includes the on-board IODebug sketch, per-lift capture logger, automatic
    bit-map inference, trip/dwell analysis, dual-lift comparison, and the
    2026-08-08 test report (14/14 blind-test events verified; lift B VS2
    wiring fault isolated).
2026-08-30 Add CLAUDE.md: project context, verified facts, and debugging lessons
    Records the confirmed pin maps for both lifts, the binary floor encoding
    and code-to-label calibration, the read-only safety rule, and the tooling
    bugs that produced wrong answers along the way - notably serial prints
    blocking the sampling loop and aliasing the fastest position bit.
2026-08-30 Multi-lift testing: health check, per-lift logs, status tracker
    Prepares for testing lifts C, D and E against lift A as the reference.
    lift_health.py checks one capture against lift A verified wiring and names
    any line that never asserts, distinguishing a genuine fault from a line the
    car simply never travelled far enough to exercise. Validated both ways:
    lift A reports HEALTHY, lift B correctly reports D24 (VS2) dead.
    log_lift.py now takes a lift name rather than deriving the filename from the
    COM port. Windows reassigns port numbers when boards are swapped, so a
    port-named log would silently append one lift data onto another; the lift
    name is stamped in the file and re-checked on open. I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
    [lift_health.py, log_lift.py]
2026-08-30 Map working labels A-E onto the building lift numbers
    The operator confirmed the real names: A=Lift 3, B=Lift 1, C=Lift 2,
    D=Lift 4. Lift 5 is inferred as E, being the only number left, and is
    flagged as unconfirmed in the docs.
    Captures are now named by building lift number - capture_lift_3.log
    rather than capture_lift.log - since the letters were only the order the
    boards happened to be plugged in and mean nothing to the lift team.
    lift_decode.py gains lift_id/lift_log/lift_label as the single source of
    naming, and every tool accepts either spelling: 2, C and "lift 2" all
    resolve to the same capture.
    Also fixes a NameError on lift_health.py's missing-capture path, which
    would have fired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
    [analyze_lift.py, audit.py, compare_lifts.py, lift_decode.py, lift_health.py, log_lift.py, probe_pin.py, reveal.py]
2026-08-30 Track the flashable IODebug.ino.hex
    Keeps the exact image running on the boards under version control, so a
    replacement Mega for Lift 2/4/5 can be programmed with avrdude alone
    rather than reinstalling the toolchain to rebuild it.
    The .elf, .bin and .eep stay ignored: they are regenerable, and the
    with_bootloader image is 261 KB of churn on every compile.
2026-08-30 Back up Lift 2's original firmware before overwriting it
    The Lift 2 board was not blank: it already ran someone else's decoder,
    printing "Binary: 000010 Decimal: 2 / COIL1: 1 / COIL2: 1" on the serial
    port. Decimal 2 matches our calibration table exactly (code 2 = floor
    label 1), so that program uses the same 6-bit binary encoding we derived.
    Flash was read out to firmware_backup/ before loading IODebug, so the
    original can be restored. Also keeps a sample of its serial output, since
    COIL1/COIL2 are signals that team identified and we have not yet mapped.
2026-08-30 Pin the one dependency the toolkit actually needs
    Without pyserial every serial tool dies at import with ModuleNotFoundError
    before it reaches the board, which looks like dead hardware rather than a
    missing package. Nothing in the repo said it was required.
2026-08-30 Lift 2: position bits perfect, all four status lines carry only noise
    Position encoding matches Lift 3 exactly - 100% single-step, codes 2..46,
    and the six bits show the same doubling of median closure time
    (917/1888/3932/9333/15444/79999 ms against Lift 3's 974/2017/4530/9332/
    15512/73988). Independently corroborated by the board's previous firmware,
    whose disassembly reveals the same D24..D29 = bit0..bit5 active-low map.
    RUNNING, SAFETY, UP and DN are a different story: they close tens of
    thousands of times but never for longer than 5-18ms, at 55-62 Hz. A
    mechanical relay needs 5-10ms just to close, so those are open-ended wires
    picking up mains hum, not signals. The same pins on Lift 3 h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
    [lift_decode.py, lift_health.py]
2026-08-30 Add the RS485 migration plan
    The transceiver goes on D0/D1 - the UART the sketch already uses and already
    excludes from the pin scan - so the firmware needs no change at all. Everything
    else in here is the traps that do not announce themselves:
    - Serial1/Serial2 sit on D16/D17/D19, which carry RUNNING, SAFETY and UP.
    Serial2.begin() sets TXEN2, which overrides DDRH and forces D16 to a
    push-pull output that pinMode cannot take back - driving HIGH into the
    RUNNING contact the first time the car moves.
    - Without fail-safe bias an idle bus chatters bytes straight into the command
    dispatcher, which has no framing. A stray 's' re-runs bug 6.1 and a stray
    'w' stops the capture silently.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
2026-08-30 Judge a line by its p99 closure, not its longest
    The second Lift 2 round trip logged one 304ms closure on SAFETY among
    79,664, every other one 2-4ms. Testing the maximum let that single sample
    relabel a dead line as healthy; a high percentile ignores the stray while
    still reacting the moment a line genuinely starts holding.
    Lift 2 re-checked after the repeat trip: position bits still perfect
    (codes 1..46, 545 floor states, 100% single-step) and all four status
    lines still noise-only, now with p99 of 3-4ms. Nothing changed on those
    wires between the two trips.
    [lift_health.py]
2026-08-30 Lift 2 troubleshooting guide
    Scanning all 52 pins rules out a mis-landed wire: nothing anywhere on the
    board carries a real status signal, only D24-D29 for position.
    The noise signature narrows it further. An unconnected INPUT_PULLUP pin
    reads a steady HIGH - the pullup wins in well under a microsecond. Reading
    2-4ms dips at mains frequency instead means the pin is attached to a long
    wire whose far end floats, acting as an antenna. So the run from the
    Arduino to the relay module exists; what never happens is the far end
    being tied to ground.
    That, plus all four lines failing together while the six position bits on
    the other module stay perfect, points at something shared across the
    status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
2026-08-30 Step 2A: spell out exactly where to put the meter probes
    The previous instruction said to measure "COM", but that label appears on
    both sides of a relay module meaning different things: the input side's
    DC- sits on the 24V rail by design, while the output side's COM is the dry
    contact that has to reach Arduino ground. The 24V reading already taken
    was almost certainly the input side, which is correct and not the suspect.
    Guide now identifies the two sides by what they look like - output
    terminals are the larger ones grouped in threes beside the blue relay
    cans - fixes the black probe on the DNMEGA1 GND terminal for all three
    measurements, and includes the working 6-channel module as a same-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
    [lift_decode.py, probe_pin.py]
2026-08-30 Archive Lift 2's pre-fix capture before restarting
    Two hours of the old capture is 99.5% induced noise from the mis-landed
    ground. Appending post-fix data to it would blend the two and make it
    impossible to tell whether the repair worked, so the new run starts on a
    clean file.
2026-08-30 Archive the uncontrolled Lift 2 run
    Fifteen minutes of traffic from other people using the lift. Valid signal
    data - it is what confirmed the ground repair worked - but not a
    controlled test, so it is kept aside rather than mixed into the run the
    operator is about to drive.
2026-08-30 Lift 2 is healthy: the fault was the output common landed on 5V
    Measuring the module's output COM against DNMEGA1 GND read 5V, not 0.
    The dry contact was returning to the Arduino's +5V rail instead of its
    ground, so closing the relay connected an INPUT_PULLUP pin to the very
    voltage the pullup already held it at - electrically invisible. Between
    closures the run acted as an antenna, which is where the 2-4ms mains-rate
    blips came from.
    After moving that one wire: all ten lines present, 100% single-step,
    codes 1..46, UP and DN cleanly exclusive, RUNNING closed only while
    moving. State changes fell from ~1,700 per 30s to 6.
    Also fixes a classifier inversion this exposed. Closure widths are on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
    [lift_health.py]
2026-08-30 Transmit-only RS485: board self-arms, PC listens
    The module to hand is a plain MAX485 with DE/RE broken out, so an
    auto-direction part is not an option. Strapping DE and RE both high makes
    the node transmit-only, which needs no GPIO from the Arduino - preserving
    the rule that no pin is ever driven - and disposes of three of the four
    traps in RS485_PLAN.md at once: the bus is never idle so fail-safe bias
    stops mattering, the PC never transmits so the dongle's RTS behaviour is
    irrelevant, and RO goes unconnected so there is no contention with the
    CH340 on D0 and uploads work with everything still wired.
    What it costs is the ability to send commands, so the sketch now boots
    straight into watch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
    [IODebug.ino, log_lift.py]
2026-08-30 RS485 link is live: validate the stream and wait past the heartbeat
    Confirmed reading over RS485 rather than the USB cable: ST lines arrive
    with nothing sent, 'h' draws no reply because the transceiver is strapped
    transmit-only, and the board reports 84 minutes of uptime - opening the
    PC-side port does not reset it the way opening the USB port would.
    Two fixes this exposed.
    log_lift.py now checks each mask is exactly 13 hex digits and counts what
    it rejects, reporting the rate while running and at the end. A USB cable
    either delivers a byte or does not; RS485 can hand over a corrupted one,
    and a mask short by a digit still parses as valid hex while shifting every
    bit - wrong data that look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
    [log_lift.py]
2026-08-30 RS485 verified against operator-timed run
    Lift 2 now reports over RS485 and the data matches the manual record: the
    operator logged arrival at floor 44 at 18:34 followed by an immediate
    descent to floor 1, and the capture shows trip 4 topping out at code 46 at
    18:34:40, an 18-second stand, then trip 5 straight back down.
    Link quality across 292 samples: every mask the correct 13 digits, zero
    rejected, zero link-lost events, 100% single-step, codes 1..46. Status
    lines behave as on the reference lift - UP and DN cleanly exclusive,
    RUNNING only while moving, SAFETY closed throughout.
2026-08-30 Compare lift ids, not raw stamps, when guarding a capture log
    capture_lift_1.log is stamped with the old letter B, from before the letters
    were mapped onto building numbers. check_owner() compared that text literally
    against the numeric stamp, so log_lift.py read the file's own history as a
    different lift and refused to record Lift 1 into Lift 1's own log.
    That would have landed at the worst moment: the first capture after the VS2
    repair, with the board freshly reconnected and the obvious suspicion being the
    wiring rather than a string compare.
    Normalise both sides through lift_id() so B and 1 match. A genuine mismatch is
    still refused, and the message now names both lifts rather than echo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
2026-08-30 Split the two machines' roles and make firmware version visible
    All five lifts move to the Gateway; this machine keeps planning, panel
    debugging and firmware upgrades over USB. The one-way RS485 link cannot
    carry an upload, so upgrades can only happen here - but because RO is left
    unconnected there is no contention on D0, so flashing works with the RS485
    wiring still in place and the Gateway never has to stop recording.
    That role split exposed a gap: nothing identified which build a board was
    running. With five lifts upgraded at different times over months, which
2026-08-30 Flash Lift 2 to 1.1.0 and prove the upgrade path end to end
    First upgrade under the new role split, and it exercised every piece:
    the board was flashed over direct USB on COM5 while the RS485 wiring
    stayed in place, and the Gateway-side capture never stopped - it recorded
    the restart marker and then the FW line, exactly as FIRMWARE_UPGRADE.md
    says it should.
    Also confirms the two markers are real rather than merely written. Opening
    the USB port reset the board and the RS485 logger caught it as clock
    6967497 -> 86; after the flash it logged FW IODebug 1.1.0. A board on the
    older build emits no FW line at all, so absence means pre-1.1.0 and never
    a link fault.
    Signals unchanged afterwards: 3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
2026-08-30 Rejects do not spike during a flash, so a spike is always a real fault
    FIRMWARE_UPGRADE.md told the Gateway operator to expect the reject counter to
    climb while a board is being reflashed. It does not, and saying so creates a
    blind spot: it trains whoever is watching to wave through the one signal that
    means the link is actually broken.
    log_lift.py increments rejects only for a line that has already passed
    startswith("ST ") and then fails the 3-part / 13-digit check. Bootloader
    traffic is binary and essentially never forms a line beginning with "ST ", so
    it hits the earlier continue and is dropped without being counted. Replaying
    110,000 bytes of STK500v2 frames through the same filter chai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
2026-08-30 Rebuild the tracked firmware hex and guard it against going stale
    A peer session flagged the committed IODebug.ino.hex as pre-1.1.0. It was
    worse than that: 7,396 bytes against the current 9,552, which makes it the
    very first build of the project - before self-arming, before the noise
    classifier, before watch mode stopped printing. Anyone flashing a
    replacement board from it would have got a firmware that prints EDGE lines
    and snapshots during capture, which is bug 6.1 and quietly loses the
    fastest-toggling bit.
    Cause: plain `arduino-cli compile` builds into a temporary directory, so
    IODebug/build/ only changes when --export-binaries is passed. It was passed
    once, at f45ca99, and never agai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
    [check_firmware_hex.py]
2026-08-30 Back the reject and ordering claims with the real Lift 2 upgrade
    The simulation said rejects stay 0 and FW lands before the restart marker. The live flash confirms both: the last ST before the upload is at 18:56:22.496 and the next line is the FW marker 58 seconds later, with nothing rejected in between, and capture_lift_2.log shows FW on the line above board-restarted rather than below it.
    Also notes a small gap the same log exposed: restart detection triggers only on ms < last_ms, so the second reboot at 18:57:24 landed on the same clock value and went unmarked. The FW line is what catches that case.
2026-08-30 Close the loop that let the tracked hex go stale
    Plain 'arduino-cli compile' builds into a temp directory, so IODebug/build/ only changes when --export-binaries is passed. It was passed once and never again, which is how the tracked image stayed at the project's first build - older than self-arming and older than the 6.1 fix, so a replacement board flashed from it would have printed EDGE lines and snapshots during capture.
    The compile step now carries the flag, check_firmware_hex.py is a step of its own between compile and upload, and the final step says to commit the rebuilt hex. Steps renumbered to 9.
2026-08-30 Detect a restart by comparing board time against the PC clock
    A peer session found that restart detection missed a reboot: this log has
    18:57:20 and 18:57:24 both at board clock 89, four seconds apart, and the
    `ms < last_ms` test saw nothing because the value did not fall. The gap is
    wider than that case - a board returning on a slightly higher value, say
    89 to 150, slips through the same way.
    Between two ST lines the board's millis() advances by the real elapsed
    time, so it should track the PC clock. Far less board time than wall time
    means the clock was reset. The test is one-sided on purpose: bunched
    delivery skews wall-time short and board-time long, which cannot trigger
    it. The marker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
    [log_lift.py]
2026-08-30 Stop two false restarts the Gateway would have seen for months
    The wall-clock rule compares board time against real time measured when a line
    is PROCESSED, not when it arrived. If the reader is descheduled while the board
    keeps emitting, the first line of the backlog looks exactly like a reset: a few
    hundred ms of board time against seconds of wall time. Bunching protects the
    lines inside a burst, which is the case the comment defended; it does not
    protect the line that opens it. On a Gateway running five loggers, any stall
    over two seconds trips it.
    Gate that rule on board uptime. A board that really restarted has just booted,
    and a stalled reader cannot make the board's uptime small. The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
    [log_lift.py]
2026-08-30 Record Gateway state before the machine moves
    The machine is being shut down to move to a hub-based connection, so what is already set up here needs to survive it: pyserial 3.5 installed (it was missing, which made every serial tool look like dead hardware), repo-local git identity, and the fact that no board is attached at all - only the two on-board legacy ports.
    Also flags what to check before the first plug-in at the new location. An RS232 hub cannot carry RS485: single-ended against differential, and RS232 swings to plus or minus 15V into a transceiver expecting 0-5V. What the design needs is a plain USB hub with one RS485 dongle per lift, each its own independent link.
    Co-Authored-By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
2026-08-30 Compile the lift id into the firmware and refuse a mismatched board
    The user chose build-time identity over EEPROM. Lift 2 is flashed with
    IODebug 1.2.2 and reports FW IODebug 1.2.2 2026-08-31 LIFT=2, read back
    off the board rather than inferred from the build. Built with
    --build-property build.extra_flags=-DLIFT_ID=2; the default is LIFT_ID 0,
    which is not a valid lift, so a build that forgot the flag announces
    LIFT=0 and shows itself.
    Two mistakes of mine along the way, both caught by testing against a real
    board rather than a quiet one:
    The identity was emitted only at boot, so a logger attached to a board
    already running never saw it and the check simply never ran - which is the
    normal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
    [IODebug.ino, log_lift.py]
2026-08-30 Build Lift 1's image and refresh the reference hex
    Lift 1's board is about to be connected, so its image is built and kept
    alongside Lift 2's - different checksums, confirming the id really is
    compiled in and the two are not interchangeable.
    check_firmware_hex.py caught the reference hex sitting at 1.2.0 while the
    source had moved to 1.2.2, which is exactly the drift it was written for.
    Rebuilt.
2026-08-30 Add a live port watcher
    Plugging a board in and then asking someone to re-run a check is a slow
    loop when the answer is usually a cable seated badly. This reports an
    arrival or removal the moment it happens, so the person at the panel can
    wiggle a connector and watch rather than wait to be told.
2026-08-30 Lift 1 on 1.2.2, and the VS2 repair has not taken
    Board flashed with LIFT_ID=1 and confirmed by reading FW IODebug 1.2.2
    2026-08-31 LIFT=1 back off it, so this board can no longer be confused
    with another.
    The repair itself did not work. Across 712 stable states covering a full
    1-to-44-and-back run, D24 toggled zero times while the other five bits
    toggled 229, 120, 54, 20 and 5 - the exact halving of a working binary
    counter with its least significant bit missing. Top code is still 23 where
    Lift 2 and Lift 3 both reach 46.
    Two corrections to my own working along the way. Before flashing I called
    VS2 dead off a single sample from a parked lift; D24 only closes on odd
    codes, so a stationary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
2026-08-30 Stop lift_health crediting time nobody was recording
    Running the health check on Lift 2 over RS485 produced negative percentages -
    D16 RUNNING -75%, D19 UP -75% - and then contradicted itself, flagging RUNNING
    and UP as "NO - check this line" while the verdict said HEALTHY. Impossible
    numbers and a self-contradicting report, which is how 6.10 was caught too.
    Two separate causes, both in how a state's hold time was measured.
    First, board resets. pulse_widths() already splits where the clock goes
    backwards; the section-3 hold computation differenced straight across the seam.
    This log has six resets from the day's reflashing, injecting -7,561s against
    5,515s of real time - 137%, enough to dri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
    [lift_health.py]
2026-08-30 Tell an undriven RS485 bus from a misread one
    Lift 1 came up on RS485 and delivered bytes that looked like data with
    broken framing: bursty, 34% printable, with repeating patterns like
    "ef ed ef ed". The obvious next moves were to chase the baud rate or
    swap A and B, and both would have been wrong.
    Sweeping the baud settles it. A real UART stream read at the wrong rate
    still arrives at the sender's message rate, because the sender decides
    when bytes exist. Noise has no message rate, so sampling it faster just
    yields more bytes. Measured 17x more bytes across a 24x baud range, and
    no valid frame at any rate: nothing is transmitting.
    The same numbers rule out swapped polarity for free. Swapp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
    [rs485_check.py]
2026-08-30 Warn off git stash while a logger holds a log open
    Pulling on the Gateway while a capture runs met a trap worth recording. git stash on a log the logger has open fails to write the working file - Windows has it locked - but the stash entry is still created and staged, and pop then drops it, leaving the index at MM against a file git never touched.
    The data survived because the OS lock stopped git, not because git was careful. A plain git pull --ff-only is the safe move: it does not touch files outside the incoming diff, and under the one-machine-per-lift rule nobody else edits the logs this machine holds.
    Also records the recovery check, including that CR has to be stripped before comparin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
2026-08-30 Fix the recovery command mangled into a no-op
    The previous commit meant to document 'tr -d BACKSLASH-r' but a heredoc turned the escape into a real carriage return, so the doc shipped 'tr -d' with empty quotes - a command that deletes nothing and would have reported a false mismatch to whoever followed it.
    Repaired at byte level; text-mode replacement kept silently reintroducing it. The command is now run and verified against the live capture rather than only read.
2026-08-30 Hand Lift 1 to the Gateway with its fault written down
    The dongle moves, the fault does not. Lift 1's RS485 pair is undriven,
    and that is at the lift end, so the Gateway will meet exactly the same
    noise on exactly the same hardware. Sending it anyway is the right call
    -- it means the data starts flowing the moment someone restores power at
    the panel, with nobody needing to move cables again -- but it is only
    the right call if the receiving end knows what it is being handed.
    So the handover section says what a healthy failure looks like there:
    rs485_check reporting UNDRIVEN in 45s, and log_lift refusing to start
    after three tries with a message that ends "and that the board has
    power". Both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
2026-09-02 Lift 2: 60 hours unattended on RS485, zero rejected lines
    The Gateway link has now run 3,598 minutes without intervention: 55,267 lines recorded, 0 rejected, 0 link-lost, and the board reporting 60.4 hours of uptime with no restart.
    Decode quality over the whole capture: 31,785 stable states, 26,031 floor changes, 26,026 of them single-step (99.98%), all 46 codes seen from B1 to floor 44, and 1,496 stops. This is a far stronger result than any of the short bench tests - the failure modes RS485_PLAN.md warned about (fail-safe bias, RTS on the dongle, contention with the CH340) would all have shown up long before now.
2026-09-02 Rule on line structure, not on which dwell caught a burst
    rs485_check returned four different verdicts for one dead link with
    nothing touched between runs: FRAMING, then UNDRIVEN three times with
    ratios of 57, 59 and 14, then SILENT. The Gateway caught it on Lift 1's
    dongle within minutes of me pushing the tool.
    The verdict rested on the byte rate rising with the baud rate. That
    reasoning is still sound -- a sender fixes when bytes exist, noise does
    not -- but noise arrives in bursts, so whether an 8s dwell catches one
    is luck, and I was computing the verdict by dividing two lucky numbers.
    Two details made it worse: the low end was the first non-zero rate
    rather than the smallest, so a high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
    [rs485_check.py]
2026-09-02 Measure both ends of the line-structure threshold
    The 3.6% figure the threshold rests on was arithmetic: one newline per
    28 bytes of protocol. Worth checking against what boards actually emit,
    because the branch that certifies a lift as GOOD had only ever been
    exercised against strings I typed by hand -- on both machines. The
    Gateway cannot close that either, since its one live port is held by an
    unbroken 60-hour capture and Windows will not share it.
    Replaying the real traffic is not a live port, but it is strictly better
    than hand-written samples: 1.8 MB reconstructed from capture_lift_1.log
    and capture_lift_2.log, every mask and millis value off a real Mega.
    63,497 frames, zero rejected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
2026-09-02 The FW line sets the newline floor, not the longest ST line
    The Gateway worked out the worst case the protocol can produce and got
    the method right: take the longest line, since line length is what the
    newline share is the reciprocal of. But the longest line is not an ST
    line. At millis maximum, just before the 49.7-day wrap, ST reaches 29 B
    and 3.45%. The FW identity line is 36 B and gives 2.78%.
    It is not a hypothetical. FW dominates whenever the lift is parked --
    nothing changes, so the only traffic is the 30s identity beacon and the
    60s heartbeat, and a 45s listen there sees one FW line and nothing else.
    That is an ordinary state for a lift at night, not an edge case.
    So the headroom i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
2026-09-02 Stop UP blessing a link where 1 line in 201 parses
    The Gateway found rs485_check reporting "UP -- the link is delivering"
    on a stream of one valid line among 200 corrupted ones, with "malformed
    state lines: 0" printed underneath it. Both halves were technically
    true and together they said the opposite of the truth.
    The short-circuit was unconditional: one frame anywhere and the function
    declared the link good, whatever arrived with it. And the malformed
    count only ever saw lines that had already parsed as ST, so pure garbage
    never reached it and it printed a clean figure on a nearly dead link.
    The junk count was on screen one line earlier, but the verdict block
    contradicted it, and the docs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
    [rs485_check.py]
2026-09-02 Write down the tell that gave away five bugs
    Every fault found in this project announced itself the same way, and
    until now that was recorded only as five separate war stories in section
    6 rather than as the one heuristic they share. Both sessions have now
    hit it independently, which is what makes it worth promoting: a report
    that disagrees with itself.
    MISSING alongside 100% correlation. Negative hold percentages above a
    HEALTHY verdict. A documented rejects spike that the code cannot
    produce. Four verdicts from one untouched link. "The link is
    delivering" printed above "malformed 0" while 200 of 201 lines were
    garbage.
    The part worth internalising is which half wins. The reassuring half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
2026-09-02 Split the lift_health row in 6.15 into its two distinct causes
    The table credited the negative percentages to counting across recording gaps. That was the second fault, not the one that produced the negatives. The negatives came from differencing across a board-clock reset - measured at -7,561s against 5,515s of real time, 137%, which is what drove the totals below zero.
    The gap fault is separate and leaves no trace in the data at all: the board keeps running, the clock does not go backwards, and the last state before the gap silently inherits the whole span. It only became visible once the negatives were gone.
    The distinction matters in a file every future session loads: someone reading t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
2026-09-02 Record which half of the delta sum is actually invariant
    The peer's point is right and this file demonstrates it. Consecutive deltas telescope, so the net equals last minus first and survives any amount of row dropping. The forward and backward sums separately do not: dropping a row beside a sign change moves value between them.
    Measured here rather than argued. debounce drops the row following two of the six board resets, and raw-versus-stable comes out forward -3 ms, backward +3 ms, net exactly 0.
    That also corrects both of us. I had called the two methods exactly equal; they differ by 3 ms and my 0.1 s display rounded it away - lesson 6.16 on my own measurement. And the reason the split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
    [lift_health.py]
2026-09-02 Lift 2: close the 77-hour capture cleanly
    Stopped via STOP_CAPTURE so the logger closed the file and wrote its own trailer rather than being killed mid-line.
    Final: 75,989 state changes over 4,644.5 minutes - 77.4 hours - with 0 rejected lines, 0 link-lost, and no board restart in the whole run. The board's clock reached 279,647,468 ms, 77.7 hours of unbroken uptime.
    Stopped at the user's request to update software; the port is released and nothing holds COM20.
2026-09-06 Do not grade a board's own startup as a bad link
    Plugged USB into Lift 1 at the panel and rs485_check immediately called
    a perfectly good link UP (DEGRADED), 9 of 14 lines unparseable. Two
    further runs on the same cable, untouched, came back 0.0%. The board had
    just been powered by that USB cable, and the 9 lines were its startup.
    This is the false positive the DEGRADED branch was always going to have,
    and it lands in the worst place: the Gateway's very first action on Lift
    1 is to run this, most likely moments after someone restores power. It
    would have reported a corrupted link and sent them to check termination
    and cable length on a link that was fine.
    Junk is now split at the first goo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
2026-09-06 Opening the port resets the board, so uptime measures the measuring
    Twice today I read a low uptime off Lift 1 and concluded the board had
    just been powered by the USB cable. The user then reported the power LED
    stays lit with USB unplugged, which killed that story, so I measured the
    port instead of theorising about it:
    open #1: board says 0.1s uptime <- opening reset it
    open #2: board says 8.2s uptime <- reopen did not; clock ran on
    board +8.1s against PC +8.2s
    The first open after the cable goes in resets the board. Later opens do
    not. It happens despite dtr=False and rts=False, which is the setting
    that is supposed to prevent exactly this. So both of my conclusions wer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
    [board_alive.py]
2026-09-06 Stop the docs sending the operator to a port that moved
    A third CH340 dongle appeared and the COM numbers shuffled: Lift 2 answers on
    COM22 now, not COM20. CH340 has no USB serial number, so the number tracks
    which socket a dongle sits in and a re-plug renumbers everything.
    Three things in the docs would have sent an operator to the wrong port, and
    the third would have told them the resulting silence was fine:
    - LIFT_STATUS.md named COM20 as Lift 2's port in the table an operator reads
    first. Following it runs log_lift against an undriven bus; the owner stamp
    passes because the file really does belong to lift 2, and the LIFT= check
    never fires because no banner arrives, so it retries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
2026-09-06 Lift 3 off the firmware that caused the worst bug in the project
    Lift 3 was still running the original build: the one that prints a
    snapshot every 3 seconds during capture. That is lesson 6.1 -- at 115200
    the TX buffer fills, the sampling loop blocks for tens of milliseconds,
    the fastest-toggling bit gets read short, and every bit shifts one place.
    It is what produced "top floor is 23" instead of 46. The reference lift
    has been carrying that firmware this whole time.
    It also had no lift id, so the Gateway could not tell which lift it was.
    Now `FW IODebug 1.2.2 2026-08-31 LIFT=3`, read back off the board.
    The build was validated before anything was flashed, because the two
    things that can g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
2026-09-06 All three lifts now answer over RS485, and Lift 1 is not the fault it was written up as
    Found by identity beacon rather than by port number, which is the only method
    that survives a re-plug:
    COM20 -> LIFT=1 COM21 -> LIFT=3 COM22 -> LIFT=2
    Lift 3 is wired and working, so the open question of whether it even had a
    MAX485 fitted is closed - it does. More importantly the reflash is verified
    from this end: the toggle cascade reads D24=16, D25=8, D26=4, D27=2, which is
    exactly 2.00x at every step, and single-step is 16/16 under the reference 6-bit
    map with zero malformed lines. That is the direct disproof of lesson 6.1, whose
    mechanism was the fastest bit being under-sampled and the whol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
2026-09-06 Halve the VS2 search: the Arduino side is proven good
    The user rewired Lift 1 and asked whether VS2 came back. It did not, and
    the evidence is as clean as this test gets: the car ran 1 -> 44 -> 1
    twice, passing every landing, and produced 74 stable readings with zero
    odd codes. Every one of the 73 transitions was exactly 2 apart. A
    working encoder steps by 1; stepping by 2 every single time is bit 0
    missing.
    Worth flagging because it reads like progress and is not: the top code
    came out 46 where earlier reports said 23. Same physical state, two
    maps. 23 is 46 halved by the VS2-dead map. Floor 44's true code is 46
    and its bit 0 is already 0, so the top of the range never exercised VS2
    at all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
2026-09-06 A live view of one wire, for whoever is holding the screwdriver
    The user is repairing Lift 1's VS2 right now, and the existing tools cannot
    help mid-repair: lift_health.py judges a whole capture after the fact, and
    rs485_check.py needs the serial port, which the running logger owns
    exclusively. So this follows the capture log the logger is already writing.
    The verdict is the one lesson 6.9 exists for, applied to a single line: a line
    that merely goes LOW is not a working line. It has to HOLD - a relay contact
    needs 5-10ms just to close, so closures that never outlast 50ms are an
    open-ended wire picking up mains hum. And a position bit has to MOVE with the
    car, so it separates DEAD / STUCK /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
    [pin_watch.py]
2026-09-06 Let probe_pin listen instead of arming, and actually print
    Two things stopped this tool being usable at the panel today.
    It always called arm_watch, which sends 'w'. On 1.2.0 and later the
    sketch arms itself at boot, so that toggles watch mode OFF and relies on
    the retry to toggle it back on. That is a hole in whatever the Gateway is
    recording, opened for no benefit, and on a one-way RS485 link the command
    cannot arrive at all. --listen opens with the control lines held low and
    waits for the board to speak, refusing to invite anyone to start
    jumpering terminals until it has heard an ST line. Silence for 75s,
    longer than the heartbeat, now fails with a pointer to board_alive.py
    rather than l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
    [probe_pin.py]
2026-09-06 pin_watch called a healthy line dead for standing still
    Lift 3's VS2 is known good and read DEAD (open) - never closes. The car was
    parked. VS2 reads HIGH at rest by design, so with no floor movement there is
    no evidence about the line either way, and the tool was reporting absence of
    opportunity as absence of signal.
    That is the same shape as 6.10 - a line called MISSING for behaving exactly as
    it should - and it was in a tool handed to someone mid-repair, where a false
    DEAD is worse than no reading at all.
    It now refuses to judge until the car has actually moved, the way it already
    refuses on too few samples. Revalidated: Lift 2's VS2 still reads WORKING,
    parked lines report that they ca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
    [pin_watch.py]
2026-09-08 Ask the boards which port they are on, instead of asking a person
    The dongles are CH340 with no USB serial number, so Windows names their ports
    by which socket they occupy and a re-plug renumbers everything. When that
    happens today, a logger either stops with a clear refusal (its port now
    carries a different lift) or spins on "link lost - retrying in 3 s" forever
    with the 15s progress line unreachable, because the exception fires at the
    open. capture_lift_1.log:1404 is 45 consecutive such lines from a real unplug.
    The information needed to recover is on the wire: every board announces
    "FW IODebug <ver> <date> LIFT=<n>" at boot and again every 30s. This reads it
    back and prints the current p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
2026-09-12 Split the VS2 fault the way the evidence already points
    The user asked how to test the relay board to tell a dead channel from a
    broken input wire. The answer turns out to be narrower than the question,
    because two of the branches are already closed.
    The Arduino side was proven good last week by jumpering GND onto DNMEGA1
    terminal 24: 757 samples, 750 odd codes, holding while the car ran with
    every other bit changing around it. And the output wire is very likely
    intact too, from a fact that reads like noise and is actually evidence.
    The Gateway saw D24 chattering at mains frequency. A genuinely floating
    pin cannot do that - with the pullup its RC is about 0.3us, so it sits
    solidly HIGH (les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
2026-09-12 Withdraw the SAFETY conclusions - that data came from bench work, not lifts
    The user confirms SAFETY has never been tested against a real lift. Everything
    I read out of the D17 line came from periods when somebody was working on the
    boards, so three conclusions are withdrawn:
    - "Lift 1 was out of service 41 minutes at floor 4 on 7 Sep" - that was the
    VS2 repair work, not the lift's safety circuit. The callout asking the
    contractor for a fault log is removed before anybody acts on it.
    - "A maintenance visit is visible on 9 Sep across all three lifts" - same.
    - Section 9 item 6 is reopened. The 677 ms pulse at 179/187 s after a stop is
    still measured and still regular, but nothing ties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
2026-09-12 Lift 5 is on IODebug 1.2.2 LIFT=5, and its number is no longer a guess
    The Gateway's handover asked for the lift id to be confirmed before
    flashing, since it is baked into the binary and a wrong one means
    another trip to the machine room. The user named Lift 5 directly in the
    instruction, so the elimination argument that had carried it since
    August is retired: 1 through 4 were stated, 5 was what remained, and now
    5 is stated too.
    The board was not blank. It was running the same third-party program
    that was on Lift 2 before we overwrote it - the one printing
    "Binary: 000010 Decimal: 2 / COIL1 / COIL2" - so the flash was read out
    to firmware_backup/lift5_original_* first, image and serial sam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
2026-09-12 Lift 5 reads clean, and two things the verdict line alone would hide
    lift_health returned HEALTHY for Lift 5 and, three sections above it,
    NO on SAFETY. That contradiction is the 6.15 tell, and following it
    found the real shape of the run.
    From 16:42 to 16:46:50 all four status lines read open at once while the
    position bits stepped perfectly and the car was moving. A lift cannot
    move with its safety chain actually open, so the lines were not being
    read, not open: the Lift 2 signature of an output common not landed. It
    came back on its own at 16:46:50 and has been solid since, 99% SAFETY
    and 93% RUNNING, which is why the summary averaged into a pass. Judged
    on the clean window alone Lift 5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
2026-09-12 Lift 5 first capture: all ten lines, cascade exactly 2.00x at every step
    Found on COM14 by its own LIFT=5 beacon, verified UP with zero unparseable lines, and recorded 124 samples while the car ran. Clean-window decode is 64 of 64 single-step with the toggle cascade at 64/32/16/8/4/2 - 2.00x at every bit, no rounding.
    The code 47 seen earlier does not appear in clean data. Those four occurrences, held 3 to 18 seconds each, fall inside the window when the cabinet machine was working on this board, and the user confirms Lift 5 tops out at floor 44 like the others. Long holds would normally rule out a transient; a test lead held against a terminal produces exactly the same signature, which is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
2026-09-12 Lift 5 blind test passes; code 47 is a real landing, not a transient
    The user rode Lift 5 from floor 1 to 44 and back down through B1 at 18:30
    on 12 Sep and reported the times afterwards. All four events line up with
    the capture: departure 18:30:40, top 18:31:55, floor 1 at 18:33:18, B1 at
    18:33:41. Single-step 92/92 = 100% (still 100% at a 1000 ms debounce),
    toggle cascade 92/46/22/10/4/2, no code 0 -- all six position bits on this
    board are wired.
    Nobody was at the cabinet during this window, so the SS9.7 rule admits it.
    That settles code 47: the car parked there with RUNNING open for 16.4 s,
    23 s in total. Relay mid-states hold 1-3 ms (SS6.13), so this is a landing.
    Withdraws the earlie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
2026-09-12 --follow: a capture finds its own board again after a re-plug
    Pull a dongle and put it back in a different socket and Windows gives it a
    different COM number -- CH340 adapters carry no serial number, so the number
    names the socket, not the board. The reconnect loop retried the old number
    forever and recorded nothing while looking perfectly healthy, which is the
    failure this codebase keeps running into: the reassuring half of the report
    is the half people act on.
    --follow keys on identity instead. On losing the port it listens to every
    unclaimed port and attaches only to one whose board has just announced
    LIFT=<its own lift> -- the same proof listen_check() already demands before
    writing a f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
    [capture_status.py, log_lift.py]
2026-09-12 Watchdog launcher and a logon task, so a dead process restarts itself
    --follow answers one of the three ways a capture disappears -- the dongle
    moved to another socket. It does nothing for the other two: the process
    dying, and the PC rebooting. Until now every logger here was a child of the
    shell that started it, so closing that would have taken all four with it and
    nothing would have brought them back.
    scripts/start_captures.ps1 starts only the lifts that have no logger, which
    makes it safe to run on a timer: on a healthy machine it prints "nothing to
    start" and exits. It resolves ports once through port_resolver.py and hands
    each logger its own, rather than letting four searches queue beh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
2026-09-12 Fix the scheduled-task installer, and record why -WhatIf hid the bug
    Register-ScheduledTask rejected the task outright:
    The task XML contains a value which is incorrectly formatted or out of
    range. (14,42):Duration:P99999999DT23H59M59S
    [TimeSpan]::MaxValue as -RepetitionDuration serialises to a duration Task
    Scheduler will not accept. Probed the alternatives on this machine: Zero is
    rejected the same way (PT0S), while omitting the duration, or giving a finite
    one, gets past XML validation.
    The worse half is how it shipped. It was tested with -WhatIf, which passed --
    because -WhatIf works by SKIPPING the side-effecting call, and
    Register-ScheduledTask was the only call in the scrip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
2026-09-12 Stop cleanly and record the baseline for the reboot test of AtLogOn
    The logon trigger is the one part of the recovery chain that cannot be
    verified without a real reboot, so this takes one. All four captures were
    stopped through STOP_CAPTURE first -- 0 rejected on every one -- so the logs
    close on a deliberate stop rather than on a kill, and the data is pushed
    before the machine goes down.
    Baseline to compare against afterwards: task lastRun 00:18:18 / nextRun
    00:33:33 / 0 missed, and the final board_ms of each lift (lift 2 at
    577,938,829, lift 3 at 537,803,730). Those boards are powered from the lift
    panel, not from USB, so they must keep counting across a PC reboot; a board_ms
    that falls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
2026-09-13 The reboot test failed: three bugs kept the watchdog from ever capturing
    The machine rebooted at 00:25 to test the logon trigger. Capture did not come
    back until 08:06 -- 7 hours 41 minutes down -- while the scheduled task ran
    every 15 minutes, reported LastTaskResult 0 every time, and missed nothing.
    Three independent faults, each sufficient on its own:
    1. "-File script.ps1 -Lifts 1,2,3,5" passes its arguments as plain strings,
    and PowerShell binds "1,2,3,5" to [int[]] by reading the commas as
    thousands separators: [int]"1,2,3,5" is 1235. The watchdog spent seven
    hours looking for a lift 1235. Now takes a string and splits it, which
    behaves the same from -File, -Command and int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
    [board_alive.py, capture_status.py, lift_decode.py, log_lift.py, monitor.py, port_resolver.py, probe_pin.py, rs485_check.py]
2026-09-13 Discard pid files left over from before the last boot, then reboot again
    Windows reuses pid numbers, so a pid file that survives a reboot can name an
    unrelated python.exe -- and the watchdog would then skip that lift for good,
    silently, which is the failure mode this project keeps meeting. Both checkers
    now treat a pid file written before the last boot as stale: the launcher
    deletes it and says so, capture_status.py ignores it. In Python the boot
    instant comes from time.time() - time.monotonic(), which on Windows counts
    from boot, so it needs no WMI call.
    Baseline for the second reboot test, taken after all four captures were
    stopped cleanly (0 rejected each, and every pid file removed, whi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
    [capture_status.py]
2026-09-13 Reboot test passes; probe ports in parallel so captures return in ~30 s
    The second reboot worked end to end. Read from capture_launcher.log rather
    than the exit code: boot 09:23:50, logon 09:24:07, task start 09:24:24 --
    off the 15-minute grid, so it was AtLogOn that fired -- pyserial imported
    through vendor/, all four lifts started on the right ports and were still
    alive 8 s later, ALL CAPTURING by 09:28. board_ms carried on for every
    board (restarts 0), so the PC reboot never touched them.
    One criterion missed: I had said captures would return within about a minute
    of logon, and they took 3 min 3 s. The task was quick; port_resolver.py was
    not. It listened to one port at a time and sat ou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
    [port_resolver.py]
